mountzelizabeth123/Unphased_schematics/huxley/README.md

Board: Huxley
# Layers: 4
Board Dimensions: 4.88in x 4.88in (124mm x 124mm)
Min Size Hole: 0.01in
# Holes: 528
Assembly Both Sides: Y
Standard Chip IO: N
Blink Vias: N
Via in pads: Y
