mountzelizabeth123/Unphased_schematics/huxley/bom/huxley_v1.1.1_sierra_bom.xls

This is a sample BOM for Sierra Circuits' online BOM pricing system. Please use this preferred format for your BOM that you upload.
Note: DNI applies to whole row. If only some specific locations of a given ITEM are not to be installed, please create two rows for that item and mark one as DNI.
BOM: Huxley
Assembly Part Number/Revision: 1.1.1
Customer / Company Name: unphased CMU 18725 / Kenneth Mai
Item # | Quantity per board | Manufacturer Part # | Do Not Install | Reference designators | Vendor (optional) | Vendor Part Number (optional) | Value (optional) | Size / Footprint (optional) | Part description/ specs (optional, but recommended) | Manfacturer (optional)
1 | 12 | CBR06C329B5GACAUTO |  | C1,C2,C3,C4,C5,C6,C7,C8,C9,C10,C11,C12 | Digikey | 399-CBR06C329B5GACAUTOCT-ND | 3.19pF | C0603
2 | 14 | CC0603KRX7R7BB104 |  | C13,C16,C17,C18,C19,C22,C23,C26,C27,C34,C35,C37,C42,C43 | Digikey | 311-1088-1-ND | 0.1u | C0604
3 | 5 | GCM188R71H102KA37D | DNI | C14,C46,C49,C53,C61,C38,C44,C48,C52,C60 | Digikey | 490-4777-1-ND | 1n | C0605
4 | 10 | GCM1885C1H100JA16D | DNI | C15,C39,C45,C47,C50,C51,C54,C55,C62,C63 | Digikey | 490-4766-1-ND | 10p | C0606
5 | 6 | CL10A106MQ8NNNC |  | C20,C24,C28,C32,C36,C40 | Digikey | 1276-1119-1-ND | 10u | C0607
6 | 5 | CL10B105KP8NNNC |  | C21,C25,C29,C33,C41 | Digikey | 1276-1946-1-ND | 1u | C0608
7 | 12 |  | DNI | C64,C65,C66,C67,C68,C69,C70,C71,C72,C73,C74,C75 | Digikey |  | ~ | C0609
8 | 1 | 1N457 |  | D1 | Digikey | 1N457FS-ND | 1N457 | DO35
9 | 6 | CT3151V1-2 |  | J1,J2,J3,J24,J35,J39 | Digikey | CT3151V1-2-ND | CT3151V1-2 | Banana Plug
10 | 12 | RF2-04A-T-00-50-G |  | J4,J5,J7,J9,J11,J13,J15,J17,J18,J19,J20,J22 | Digikey | 2057-RF2-04A-T-00-50-G-ND | SMA_RF2-04A-T-00-50-G | SMA
11 | 1 | 10129382-930001BLF |  | J6 | Digikey | 10129382-930001BLF-ND | ~ | 30pin 2row 0.1" R/A
12 | 8 | 61300211121 |  | J21,J25,J26,J27,J28,J29,J30,J31 | Digikey | 732-5315-ND | 61300211121 | 0.1" 2pin header
13 | 1 | 61300311121 |  | J32 | Digikey | 732-5316-ND | 61300211121 | 0.1" 2pin header
14 | 2 | CT3151V1-0 |  | J34,J37 | Digikey | CT3151V1-0-ND | CT3151V1-0 | Banana Plug
15 | 12 | RCP0603W50R0GEB |  | R1,R2,R3,R4,R5,R6,R7,R8,R9,R10,R11,R12 | Digikey | 541-2655-1-ND | 50 | R0603
16 | 1 | RC0603FR-071K62L |  | R13 | Digikey | 311-1.62KHRCT-ND | 1.62k | R0603
17 | 1 | RC0603FR-0716K2L |  | R14 | Digikey | 311-16.2KHRCT-ND | 16.2k | R0603
18 | 1 | RT0603BRC07500RL |  | R15 | Digikey | 13-RT0603BRC07500RLCT-ND | 500 | R0603
19 | 1 | AC0603FR-0775KL |  | R16 | Digikey | YAG3629CT-ND | 75k | R0603
20 | 1 | PATT0603E8982BGT1 |  | R17 | Digikey | 764-1031-1-ND | 89.8k | R0603
21 | 1 | AC0603FR-0766K5L |  | R18 | Digikey | YAG3623CT-ND | 66.5k | R0603
22 | 1 | RMCF0603FT750K |  | R19 | Digikey | RMCF0603FT750KCT-ND | 750k | R0603
23 | 1 | RN73H1JTTD8983D50 |  | R20 | Digikey | 2019-RN73H1JTTD8983D50CT-ND | 898k | R0603
24 | 1 | RC0603FR-07665KL |  | R21 | Digikey | 311-665KHRCT-ND | 665k | R0603
25 | 1 | RMCF0603JT10K0CT-ND |  | R22 | Digikey | RMCF0603JT10K0 | 10k | R0603
26 | 1 | 225-PRS15001-12 |  | U1 | Digikey | A315-ND | ~ | PGA-ZIP pin socket
27 | 1 | LM134H |  | U2 | Digikey | 296-38977-ND | LM134H | TO-46-3
28 | 1 | MAX40201FAUA+ |  | U3 | Digikey | MAX40201FAUA+-ND | MAX40201FAUA+ | MSOP-8 (3mm)
29 | 2 | TMUX1112PWR |  | U4,U5 | Digikey | 296-TMUX1111PWRCT-ND | TMUX1112PWR | TSSOP-16 (4.4mm)
 | 1 | NVT2010PW,118 |  | U6 | Digikey | 568-5299-1-ND | NVT2010PW_118 | TSSOP-24 (4.4mm)
END OF BOM
