mountzelizabeth123/Unphased_schematics/huxley/huxley-rounded.kicad_pcb

## KiCad design huxley/huxley-rounded.kicad_pcb (2024-11-19)

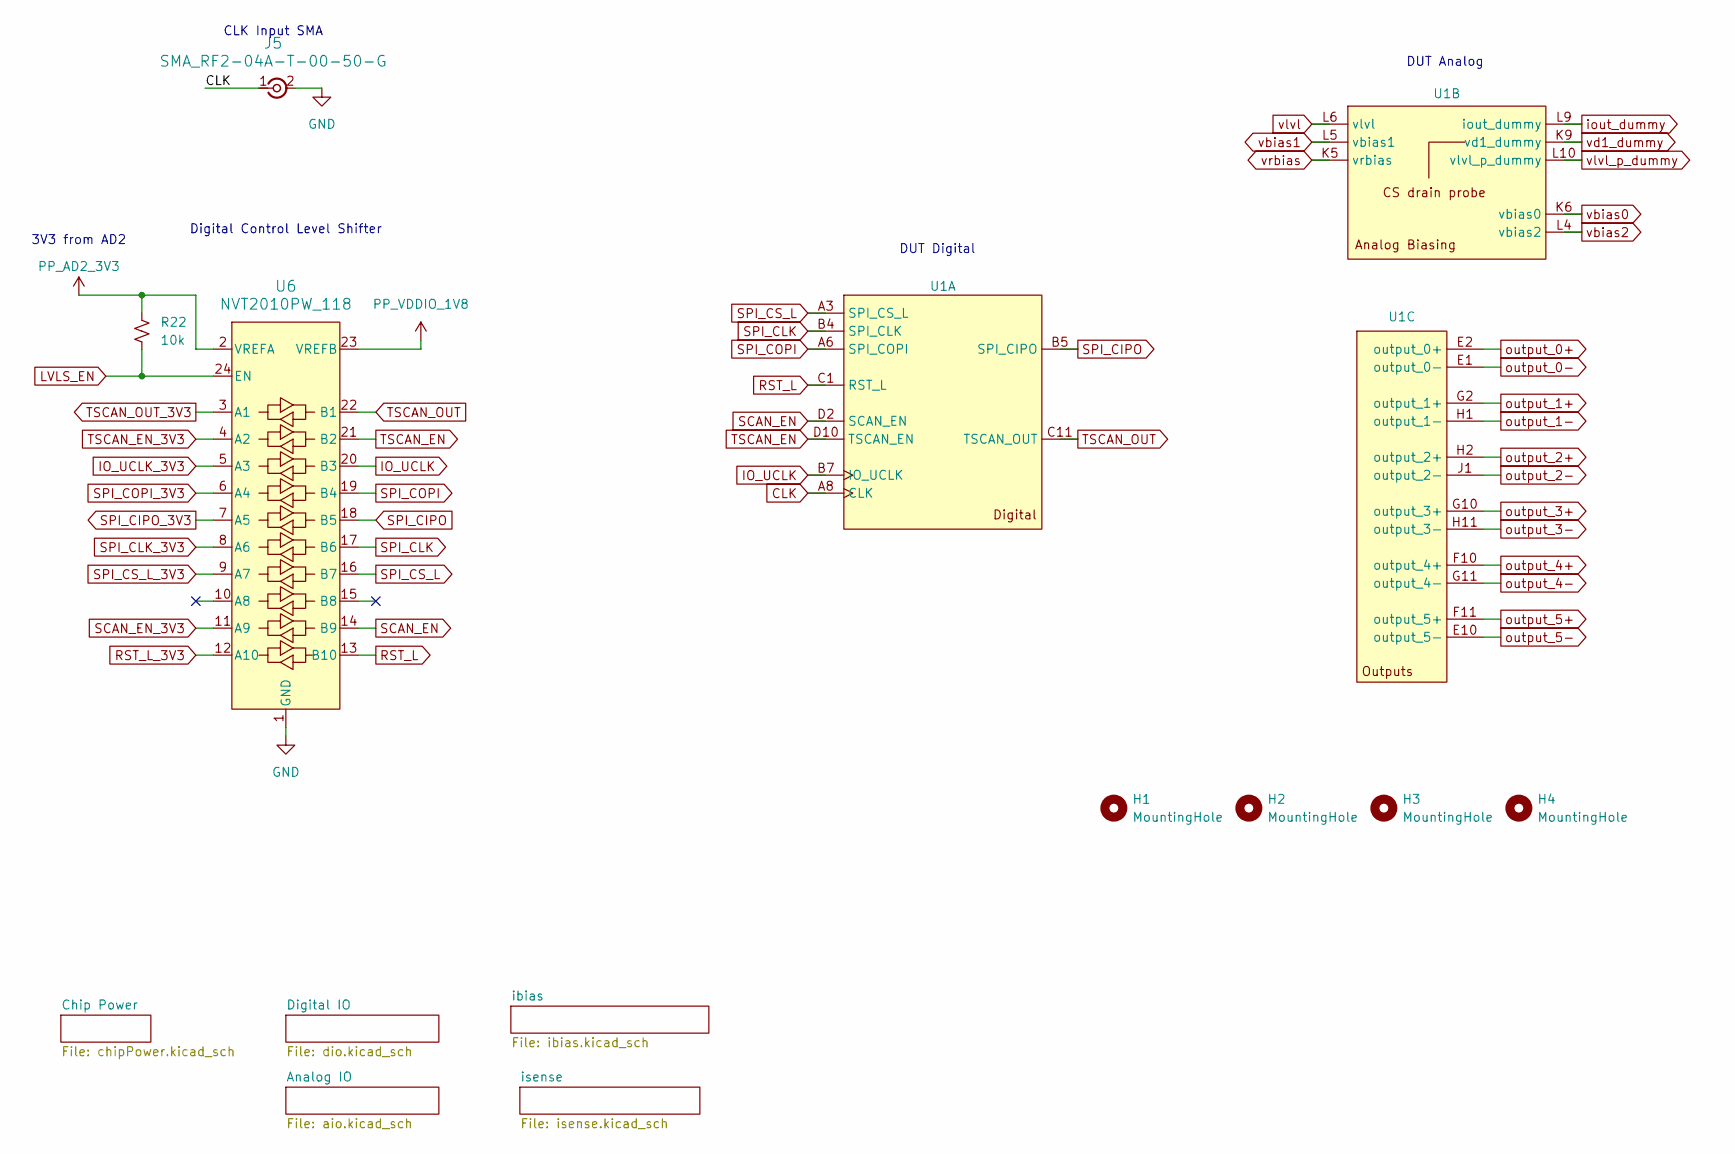
[picture p1: schematic huxley-rounded.kicad_sch]

Parts:
H1, H2, H3, H4: MountingHole; MountingHole_3.2mm_M3_DIN965_Pad_TopBottom
J5: SMA_RF2-04A-T-00-50-G; CONN_RF2-04A-T-00-50-G_ADM
R22: 10k; R_0603_1608Metric
U1: CPG08462_Full
U6: NVT2010PW_118; TSSOP24_SOT355-1_NXP

Connections:
CLK: J5.1, U1.A8 (CLK); also elsewhere on the board
GND: J5.2, J5.3 (Ext), J5.4 (Ext), J5.5 (Ext), U6.1 (GND); also elsewhere on the board
IO_UCLK: U1.B7 (IO_UCLK), U6.20 (B3)
IO_UCLK_3V3: U6.5 (A3); also elsewhere on the board
LVLS_EN: R22.2, U6.24 (EN); also elsewhere on the board
PP_AD2_3V3: R22.1, U6.2 (VREFA); also elsewhere on the board
PP_VDDIO_1V8: U6.23 (VREFB); also elsewhere on the board
RST_L: U1.C1 (RST_L), U6.13 (B10)
RST_L_3V3: U6.12 (A10); also elsewhere on the board
SCAN_EN: U1.D2 (SCAN_EN), U6.14 (B9)
SCAN_EN_3V3: U6.11 (A9); also elsewhere on the board
SPI_CIPO: U1.B5 (SPI_CIPO), U6.18 (B5)
SPI_CIPO_3V3: U6.7 (A5); also elsewhere on the board
SPI_CLK: U1.B4 (SPI_CLK), U6.17 (B6)
SPI_CLK_3V3: U6.8 (A6); also elsewhere on the board
SPI_COPI: U1.A6 (SPI_COPI), U6.19 (B4)
SPI_COPI_3V3: U6.6 (A4); also elsewhere on the board
SPI_CS_L: U1.A3 (SPI_CS_L), U6.16 (B7)
SPI_CS_L_3V3: U6.9 (A7); also elsewhere on the board
TSCAN_EN: U1.D10 (TSCAN_EN), U6.21 (B2)
TSCAN_EN_3V3: U6.4 (A2); also elsewhere on the board
TSCAN_OUT: U1.C11 (TSCAN_OUT), U6.22 (B1)
TSCAN_OUT_3V3: U6.3 (A1); also elsewhere on the board
iout_dummy: U1.L9 (iout_dummy); also elsewhere on the board
output_0+: U1.E2 (output_0+); also elsewhere on the board
output_0-: U1.E1 (output_0-); also elsewhere on the board
output_1+: U1.G2 (output_1+); also elsewhere on the board
output_1-: U1.H1 (output_1-); also elsewhere on the board
output_2+: U1.H2 (output_2+); also elsewhere on the board
output_2-: U1.J1 (output_2-); also elsewhere on the board
output_3+: U1.G10 (output_3+); also elsewhere on the board
output_3-: U1.H11 (output_3-); also elsewhere on the board
output_4+: U1.F10 (output_4+); also elsewhere on the board
output_4-: U1.G11 (output_4-); also elsewhere on the board
output_5+: U1.F11 (output_5+); also elsewhere on the board
output_5-: U1.E10 (output_5-); also elsewhere on the board
vbias0: U1.K6 (vbias0); also elsewhere on the board
vbias1: U1.L5 (vbias1); also elsewhere on the board
vbias2: U1.L4 (vbias2); also elsewhere on the board
vd1_dummy: U1.K9 (vd1_dummy); also elsewhere on the board
vlvl: U1.L6 (vlvl); also elsewhere on the board
vlvl_p_dummy: U1.L10 (vlvl_p_dummy); also elsewhere on the board
vrbias: U1.K5 (vrbias); also elsewhere on the board

Notes on the sheet:
DUT Digital
DUT Analog
CLK Input SMA
3V3 from AD2
Digital Control Level Shifter

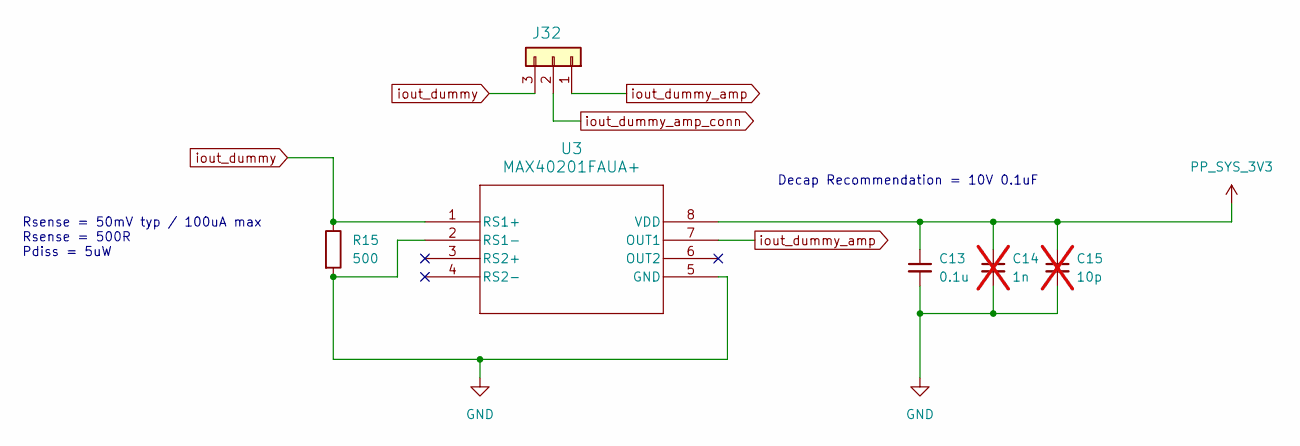
[picture p2: schematic isense.kicad_sch]

Parts:
C13: 0.1u; C_0603_1608Metric
C14: 1n; C_0603_1608Metric; not fitted
C15: 10p; C_0603_1608Metric; not fitted
J32: 61300211121; PinHeader_1x03_P2.54mm_Vertical
R15: 500; R_0603_1608Metric
U3: MAX40201FAUA+

Connections:
GND: C13.2, C14.2, C15.2, R15.2, U3.2 (RS1-), U3.5 (GND); also elsewhere on the board
PP_SYS_3V3: C13.1, C14.1, C15.1, U3.8 (VDD); also elsewhere on the board
iout_dummy: J32.3, R15.1, U3.1 (RS1+); also elsewhere on the board
iout_dummy_amp: J32.1, U3.7 (OUT1)
iout_dummy_amp_conn: J32.2; also elsewhere on the board

Notes on the sheet:
Decap Recommendation = 10V 0.1uF
Rsense = 50mV typ / 100uA max Rsense = 500R Pdiss = 5uW

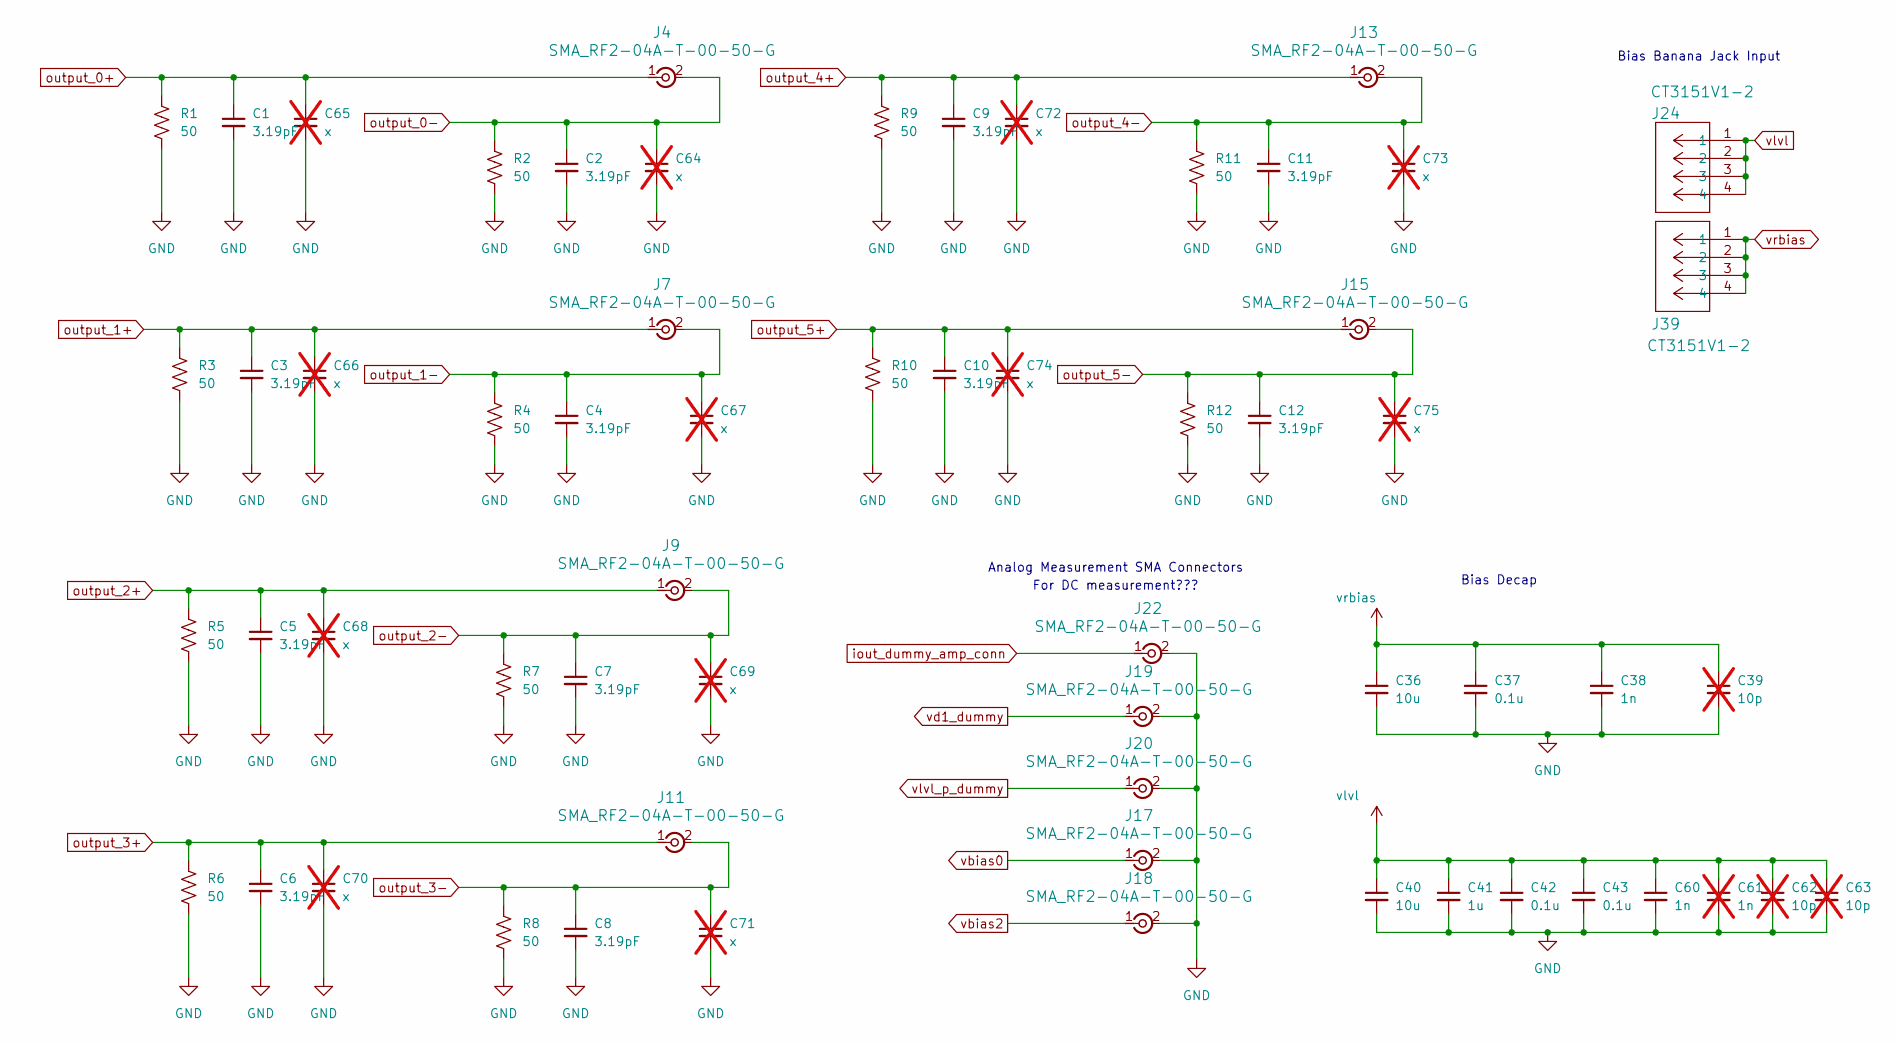
[picture p3: schematic aio.kicad_sch]

Parts:
C1, C2, C3, C4, C5, C6, C7, C8, C9, C10, C11, C12: 3.19pF; C_0603_1608Metric
C36, C40: 10u; C_0603_1608Metric
C37, C42, C43: 0.1u; C_0603_1608Metric
C38, C60: 1n; C_0603_1608Metric
C39, C62, C63: 10p; C_0603_1608Metric; not fitted
C41: 1u; C_0603_1608Metric
C61: 1n; C_0603_1608Metric; not fitted
C64, C65, C66, C67, C68, C69, C70, C71, C72, C73, C74, C75: x; C_0603_1608Metric; not fitted
J4, J7, J9, J11, J13, J15, J17, J18, J19, J20, J22: SMA_RF2-04A-T-00-50-G; CONN_RF2-04A-T-00-50-G_ADM
J24, J39: CT3151V1-2; banana_plug_CT3151V1-0
R1, R2, R3, R4, R5, R6, R7, R8, R9, R10, R11, R12: 50; R_0603_1608Metric_Vishay_WBT

Connections:
GND: C1.2, C2.2, C3.2, C4.2, C5.2, C6.2, C7.2, C8.2, C9.2, C10.2, C11.2, C12.2, C36.2, C37.2, C38.2, C39.2, C40.2, C41.2, C42.2, C43.2, C60.2, C61.2, C62.2, C63.2, C64.2, C65.2, C66.2, C67.2, C68.2, C69.2, C70.2, C71.2, C72.2, C73.2, C74.2, C75.2, J17.2, J17.3 (Ext), J17.4 (Ext), J17.5 (Ext), J18.2, J18.3 (Ext), J18.4 (Ext), J18.5 (Ext), J19.2, J19.3 (Ext), J19.4 (Ext), J19.5 (Ext), J20.2, J20.3 (Ext), J20.4 (Ext), J20.5 (Ext), J22.2, J22.3 (Ext), J22.4 (Ext), J22.5 (Ext), R1.2, R2.2, R3.2, R4.2, R5.2, R6.2, R7.2, R8.2, R9.2, R10.2, R11.2, R12.2; also elsewhere on the board
iout_dummy_amp_conn: J22.1; also elsewhere on the board
output_0+: C1.1, C65.1, J4.1, R1.1; also elsewhere on the board
output_0-: C2.1, C64.1, J4.2, J4.3 (Ext), J4.4 (Ext), J4.5 (Ext), R2.1; also elsewhere on the board
output_1+: C3.1, C66.1, J7.1, R3.1; also elsewhere on the board
output_1-: C4.1, C67.1, J7.2, J7.3 (Ext), J7.4 (Ext), J7.5 (Ext), R4.1; also elsewhere on the board
output_2+: C5.1, C68.1, J9.1, R5.1; also elsewhere on the board
output_2-: C7.1, C69.1, J9.2, J9.3 (Ext), J9.4 (Ext), J9.5 (Ext), R7.1; also elsewhere on the board
output_3+: C6.1, C70.1, J11.1, R6.1; also elsewhere on the board
output_3-: C8.1, C71.1, J11.2, J11.3 (Ext), J11.4 (Ext), J11.5 (Ext), R8.1; also elsewhere on the board
output_4+: C9.1, C72.1, J13.1, R9.1; also elsewhere on the board
output_4-: C11.1, C73.1, J13.2, J13.3 (Ext), J13.4 (Ext), J13.5 (Ext), R11.1; also elsewhere on the board
output_5+: C10.1, C74.1, J15.1, R10.1; also elsewhere on the board
output_5-: C12.1, C75.1, J15.2, J15.3 (Ext), J15.4 (Ext), J15.5 (Ext), R12.1; also elsewhere on the board
vbias0: J17.1; also elsewhere on the board
vbias2: J18.1; also elsewhere on the board
vd1_dummy: J19.1; also elsewhere on the board
vlvl: C40.1, C41.1, C42.1, C43.1, C60.1, C61.1, C62.1, C63.1, J24.1, J24.2, J24.3, J24.4; also elsewhere on the board
vlvl_p_dummy: J20.1; also elsewhere on the board
vrbias: C36.1, C37.1, C38.1, C39.1, J39.1, J39.2, J39.3, J39.4; also elsewhere on the board

Notes on the sheet:
Analog Measurement SMA Connectors
Bias Decap
Bias Banana Jack Input
For DC measurement???

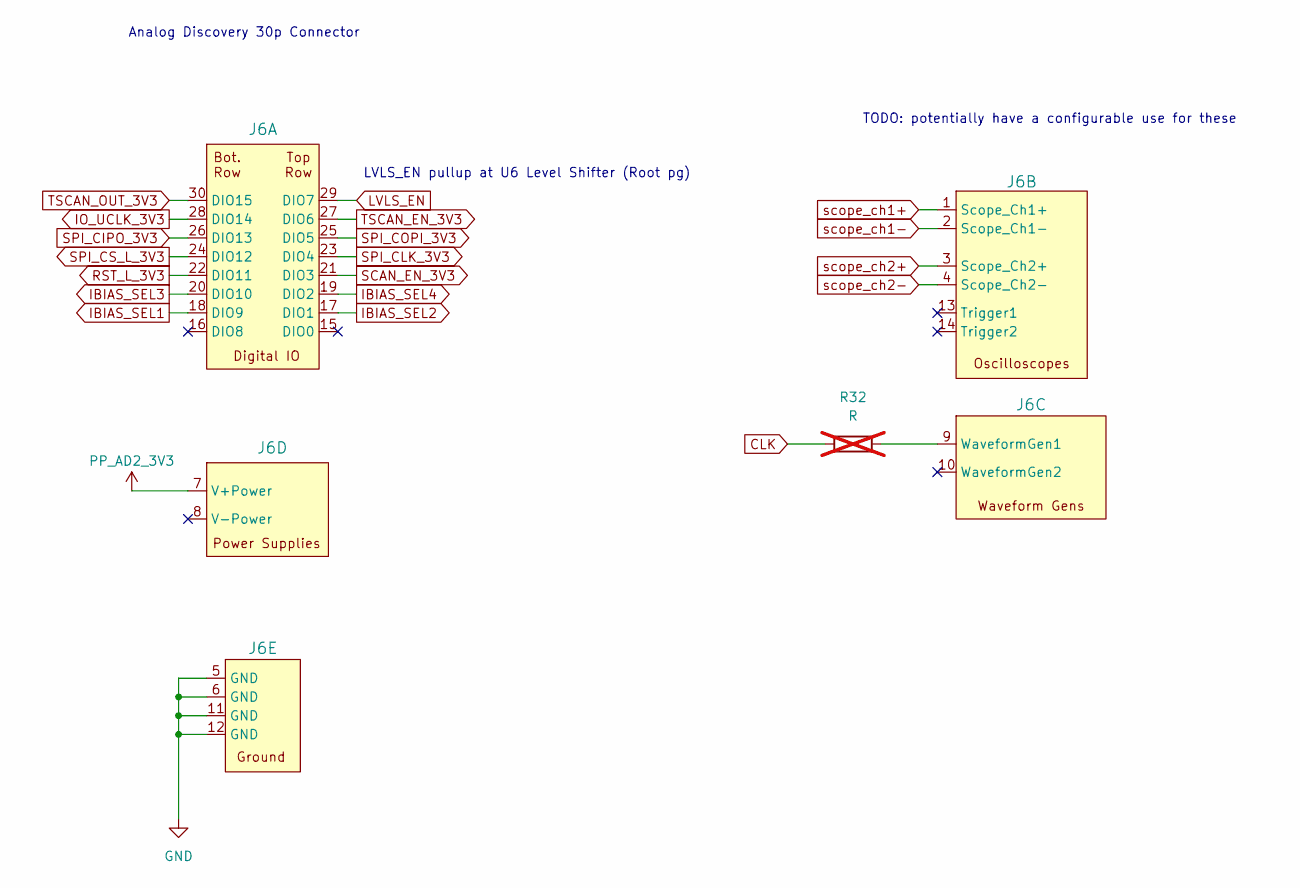
[picture p4: schematic dio.kicad_sch]

Parts:
J6: PinHeader_2x15_P2.54mm_Horizontal
R32: R; R_0603_1608Metric; not fitted

Connections:
CLK: R32.1; also elsewhere on the board
GND: J6.5 (GND), J6.6 (GND), J6.11 (GND), J6.12 (GND); also elsewhere on the board
IBIAS_SEL1: J6.18 (DIO9); also elsewhere on the board
IBIAS_SEL2: J6.17 (DIO1); also elsewhere on the board
IBIAS_SEL3: J6.20 (DIO10); also elsewhere on the board
IBIAS_SEL4: J6.19 (DIO2); also elsewhere on the board
IO_UCLK_3V3: J6.28 (DIO14); also elsewhere on the board
LVLS_EN: J6.29 (DIO7); also elsewhere on the board
unnamed: J6.9 (WaveformGen1), R32.2
PP_AD2_3V3: J6.7 (V+Power); also elsewhere on the board
RST_L_3V3: J6.22 (DIO11); also elsewhere on the board
SCAN_EN_3V3: J6.21 (DIO3); also elsewhere on the board
SPI_CIPO_3V3: J6.26 (DIO13); also elsewhere on the board
SPI_CLK_3V3: J6.23 (DIO4); also elsewhere on the board
SPI_COPI_3V3: J6.25 (DIO5); also elsewhere on the board
SPI_CS_L_3V3: J6.24 (DIO12); also elsewhere on the board
TSCAN_EN_3V3: J6.27 (DIO6); also elsewhere on the board
TSCAN_OUT_3V3: J6.30 (DIO15); also elsewhere on the board
scope_ch1+: J6.1 (Scope_Ch1+)
scope_ch1-: J6.2 (Scope_Ch1-)
scope_ch2+: J6.3 (Scope_Ch2+)
scope_ch2-: J6.4 (Scope_Ch2-)

Notes on the sheet:
Analog Discovery 30p Connector
LVLS_EN pullup at U6 Level Shifter (Root pg)
TODO: potentially have a configurable use for these

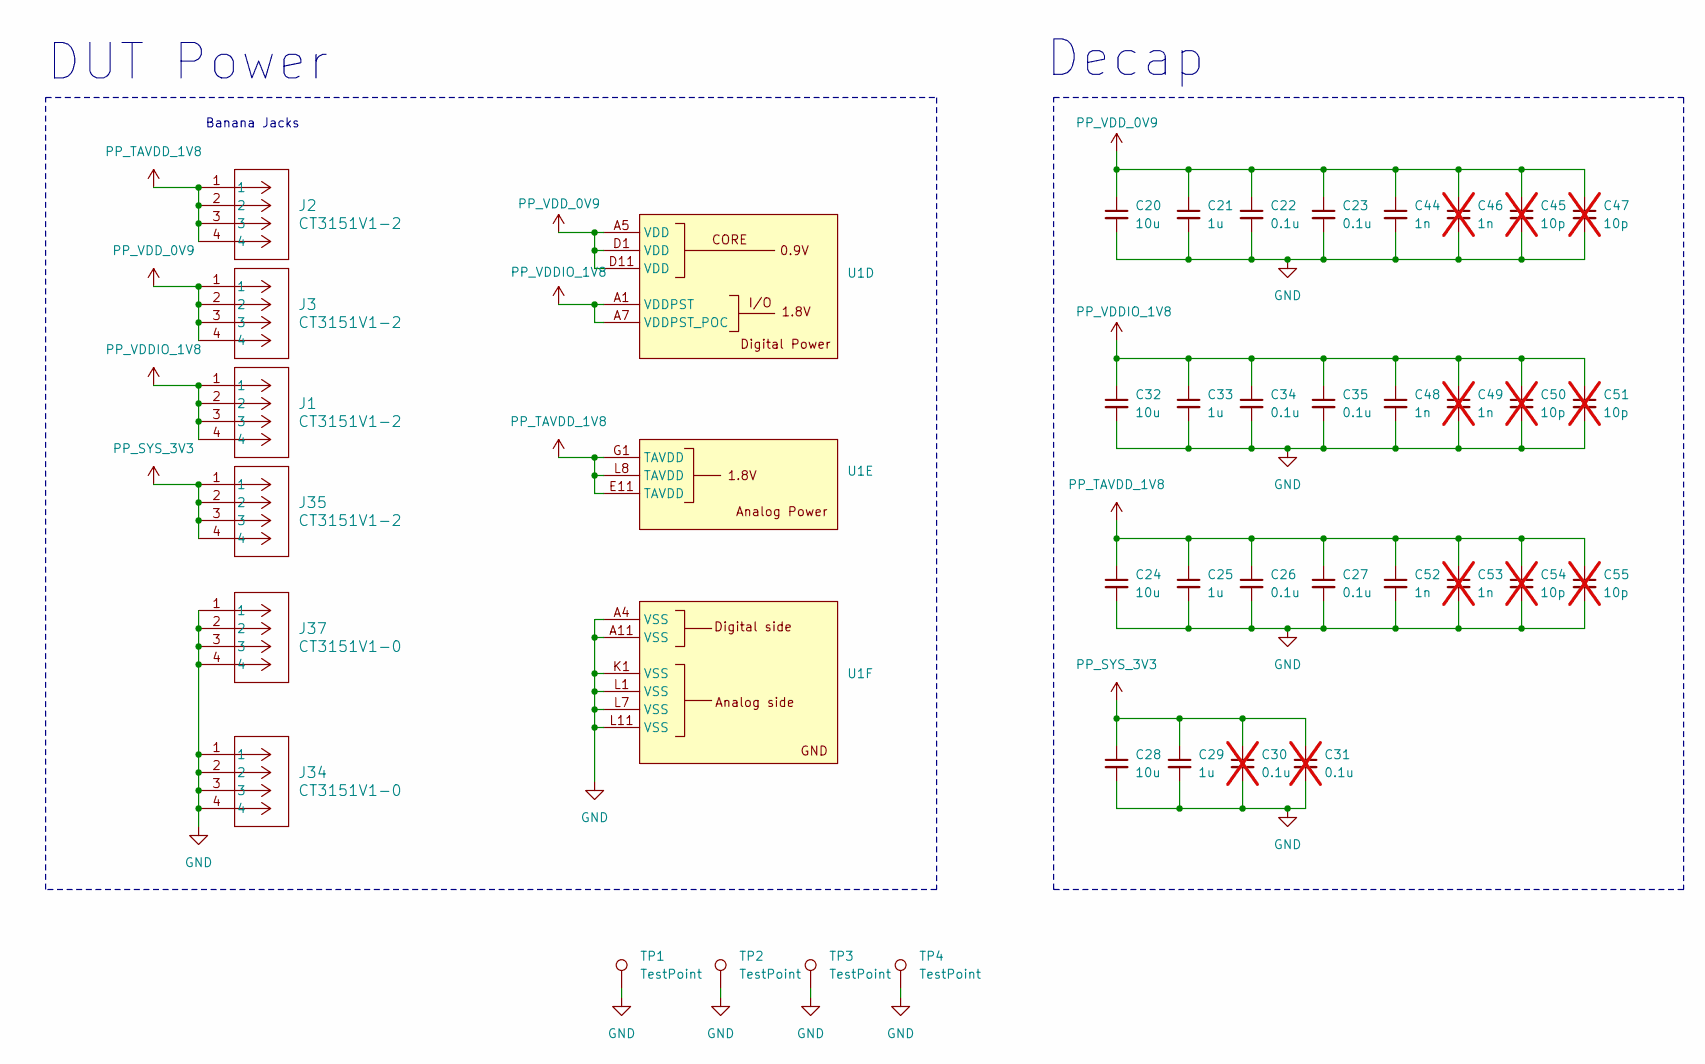
[picture p5: schematic chipPower.kicad_sch]

Parts:
C20, C24, C28, C32: 10u; C_0603_1608Metric
C21, C25, C29, C33: 1u; C_0603_1608Metric
C22, C23, C26, C27, C34, C35: 0.1u; C_0603_1608Metric
C30, C31: 0.1u; C_0603_1608Metric; not fitted
C44, C48, C52: 1n; C_0603_1608Metric
C45, C47, C50, C51, C54, C55: 10p; C_0603_1608Metric; not fitted
C46, C49, C53: 1n; C_0603_1608Metric; not fitted
J1, J2, J3, J35: CT3151V1-2; banana_plug_CT3151V1-0
J34, J37: CT3151V1-0; banana_plug_CT3151V1-0
TP1, TP2, TP3, TP4: TestPoint; TestPoint_Pad_D3.0mm
U1: CPG08462_Full

Connections:
GND: C20.2, C21.2, C22.2, C23.2, C24.2, C25.2, C26.2, C27.2, C28.2, C29.2, C30.2, C31.2, C32.2, C33.2, C34.2, C35.2, C44.2, C45.2, C46.2, C47.2, C48.2, C49.2, C50.2, C51.2, C52.2, C53.2, C54.2, C55.2, J34.1, J34.2, J34.3, J34.4, J37.1, J37.2, J37.3, J37.4, TP1.1, TP2.1, TP3.1, TP4.1, U1.A4 (VSS), U1.A11 (VSS), U1.K1 (VSS), U1.L1 (VSS), U1.L7 (VSS), U1.L11 (VSS); also elsewhere on the board
PP_SYS_3V3: C28.1, C29.1, C30.1, C31.1, J35.1, J35.2, J35.3, J35.4; also elsewhere on the board
PP_TAVDD_1V8: C24.1, C25.1, C26.1, C27.1, C52.1, C53.1, C54.1, C55.1, J2.1, J2.2, J2.3, J2.4, U1.E11 (TAVDD), U1.G1 (TAVDD), U1.L8 (TAVDD)
PP_VDDIO_1V8: C32.1, C33.1, C34.1, C35.1, C48.1, C49.1, C50.1, C51.1, J1.1, J1.2, J1.3, J1.4, U1.A1 (VDDPST), U1.A7 (VDDPST_POC); also elsewhere on the board
PP_VDD_0V9: C20.1, C21.1, C22.1, C23.1, C44.1, C45.1, C46.1, C47.1, J3.1, J3.2, J3.3, J3.4, U1.A5 (VDD), U1.D1 (VDD), U1.D11 (VDD)

Notes on the sheet:
Decap
DUT Power
Banana Jacks

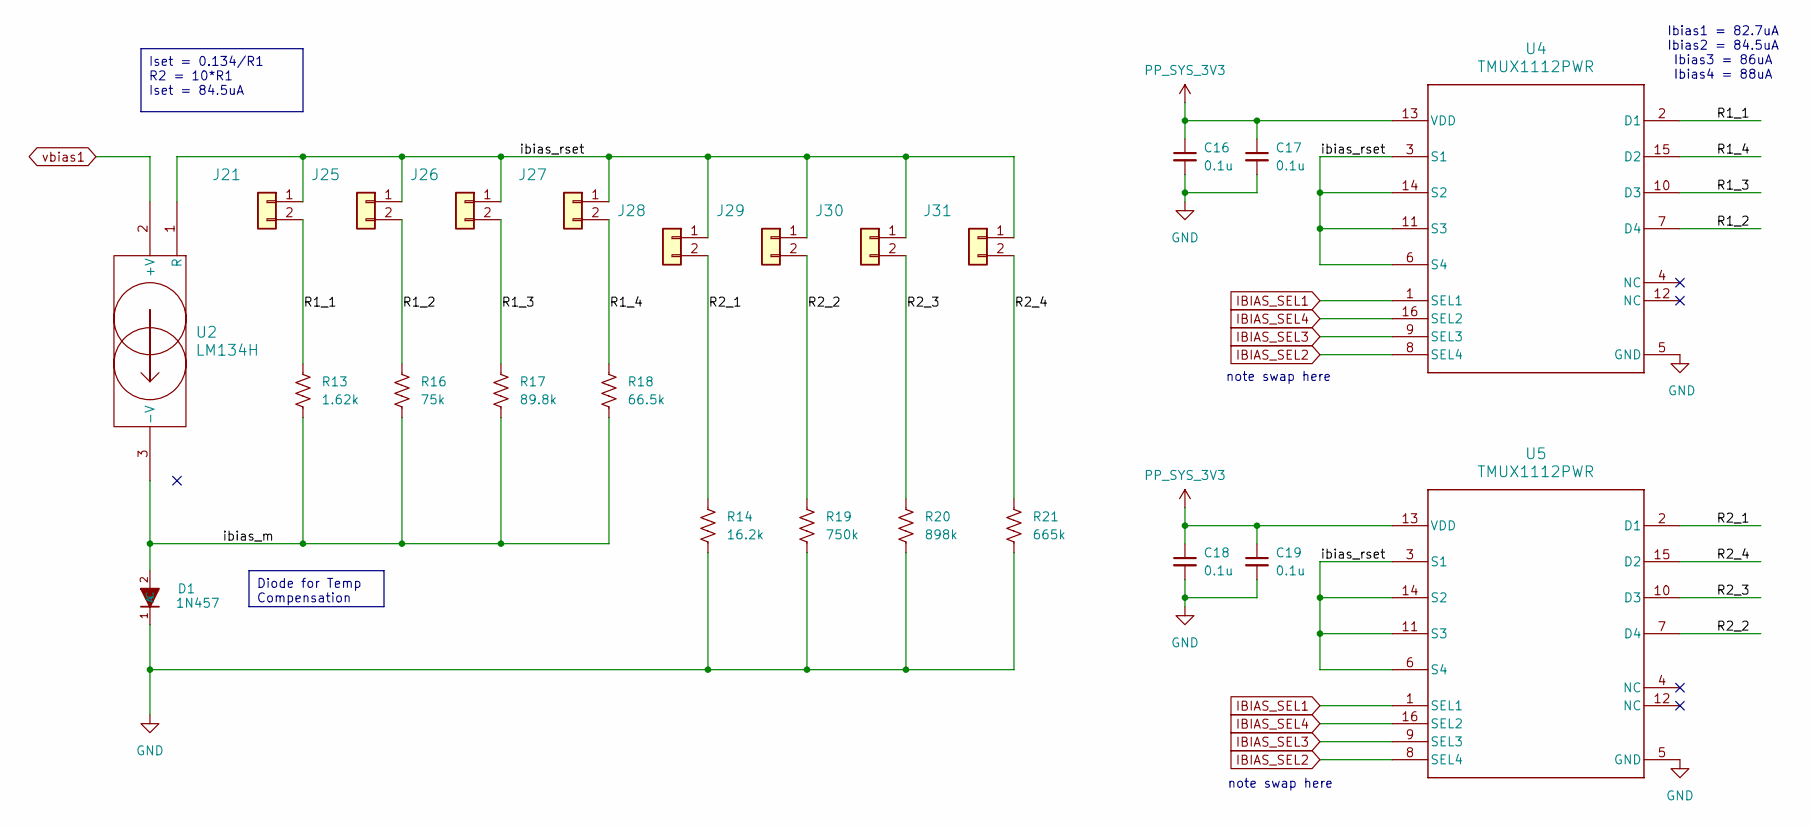
[picture p6: schematic ibias.kicad_sch]

Parts:
C16, C17, C18, C19: 0.1u; C_0603_1608Metric
D1: 1N457; DIO_1N457; MPN 1N457
J21, J25, J26, J27, J28, J29, J30, J31: 61300211121; PinHeader_1x02_P2.54mm_Vertical
R13: 1.62k; R_0603_1608Metric
R14: 16.2k; R_0603_1608Metric
R16: 75k; R_0603_1608Metric
R17: 89.8k; R_0603_1608Metric
R18: 66.5k; R_0603_1608Metric
R19: 750k; R_0603_1608Metric
R20: 898k; R_0603_1608Metric
R21: 665k; R_0603_1608Metric
U2: LM134H; TO-46-3
U4, U5: TMUX1112PWR; TSSOP-16_4.4x5mm_P0.65mm

Connections:
/ibias/R1_1: J21.2, R13.1, U4.2 (D1)
/ibias/R1_2: J25.2, R16.1, U4.7 (D4)
/ibias/R1_3: J26.2, R17.1, U4.10 (D3)
/ibias/R1_4: J27.2, R18.1, U4.15 (D2)
/ibias/R2_1: J28.2, R14.1, U5.2 (D1)
/ibias/R2_2: J29.2, R19.1, U5.7 (D4)
/ibias/R2_3: J30.2, R20.1, U5.10 (D3)
/ibias/R2_4: J31.2, R21.1, U5.15 (D2)
/ibias/ibias_m: D1.2 (A), R13.2, R16.2, R17.2, R18.2, U2.3 (-V)
/ibias/ibias_rset: J21.1, J25.1, J26.1, J27.1, J28.1, J29.1, J30.1, J31.1, U2.1 (R), U4.3 (S1), U4.6 (S4), U4.11 (S3), U4.14 (S2), U5.3 (S1), U5.6 (S4), U5.11 (S3), U5.14 (S2)
GND: C16.2, C17.2, C18.2, C19.2, D1.1 (C), R14.2, R19.2, R20.2, R21.2, U4.5 (GND), U5.5 (GND); also elsewhere on the board
IBIAS_SEL1: U4.1 (SEL1), U5.1 (SEL1); also elsewhere on the board
IBIAS_SEL2: U4.8 (SEL4), U5.8 (SEL4); also elsewhere on the board
IBIAS_SEL3: U4.9 (SEL3), U5.9 (SEL3); also elsewhere on the board
IBIAS_SEL4: U4.16 (SEL2), U5.16 (SEL2); also elsewhere on the board
PP_SYS_3V3: C16.1, C17.1, C18.1, C19.1, U4.13 (VDD), U5.13 (VDD); also elsewhere on the board
vbias1: U2.2 (+V); also elsewhere on the board

Notes on the sheet:
Iset = 0.134/R1 R2 = 10*R1 Iset = 84.5uA
Diode for Temp Compensation
Ibias1 = 82.7uA Ibias2 = 84.5uA Ibias3 = 86uA Ibias4 = 88uA
note swap here

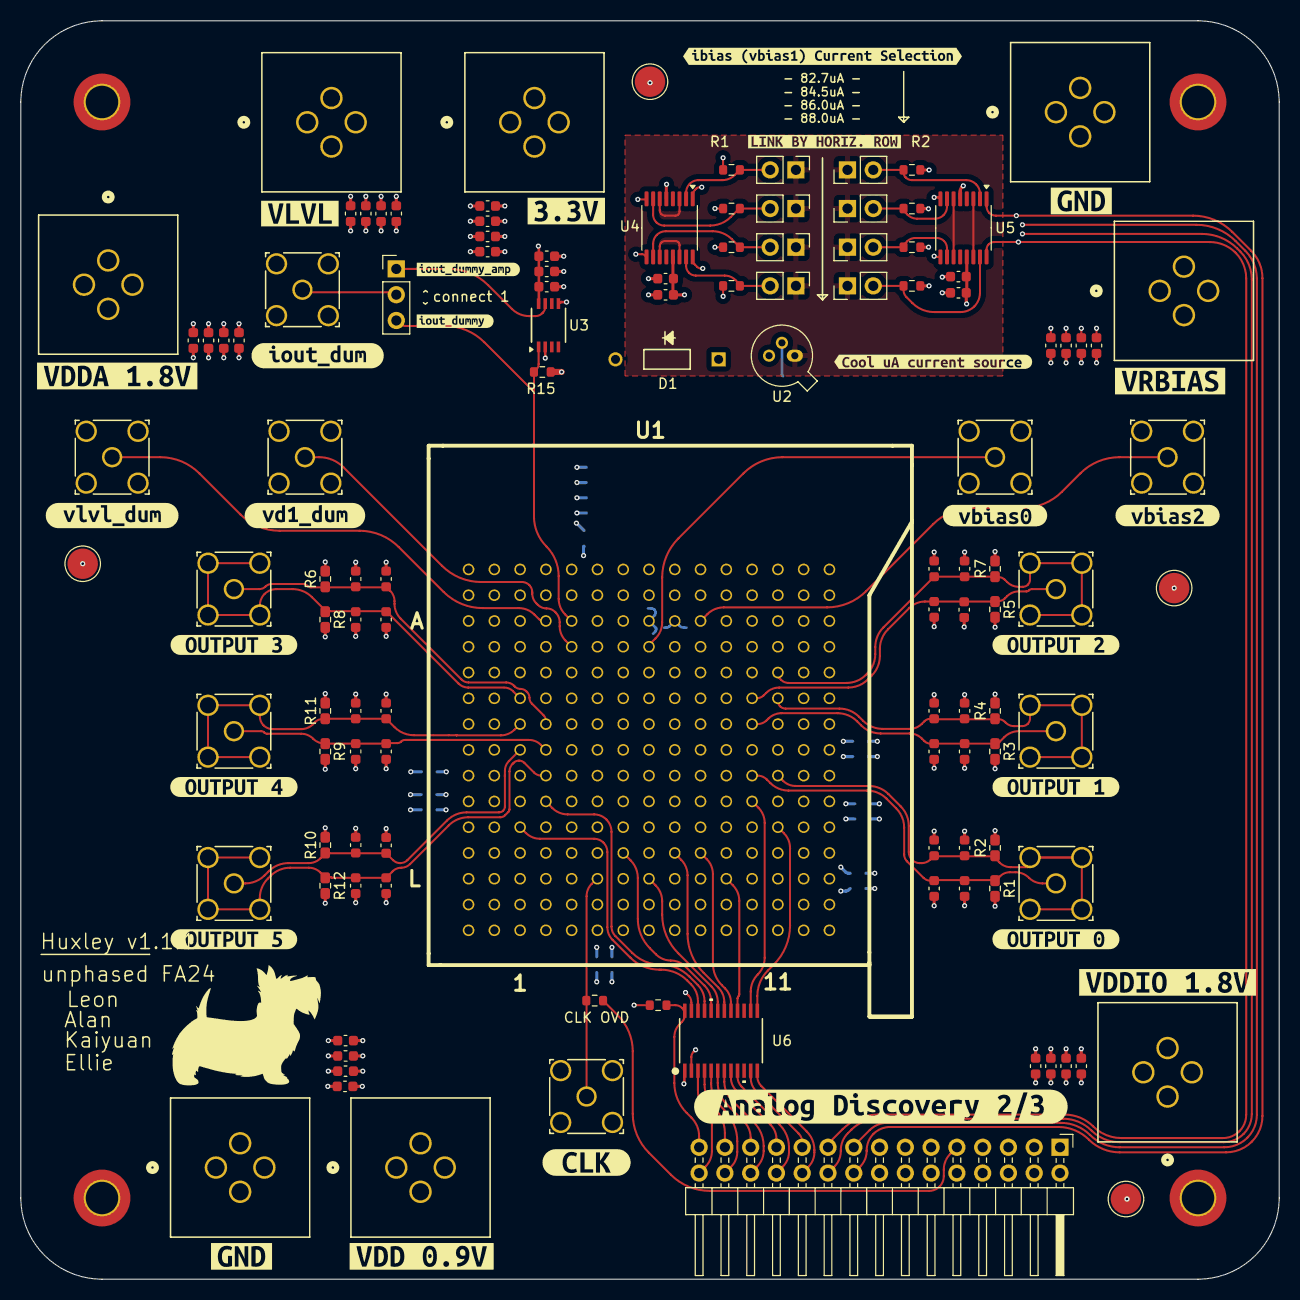
[picture p7: board huxley-rounded.kicad_pcb from above]

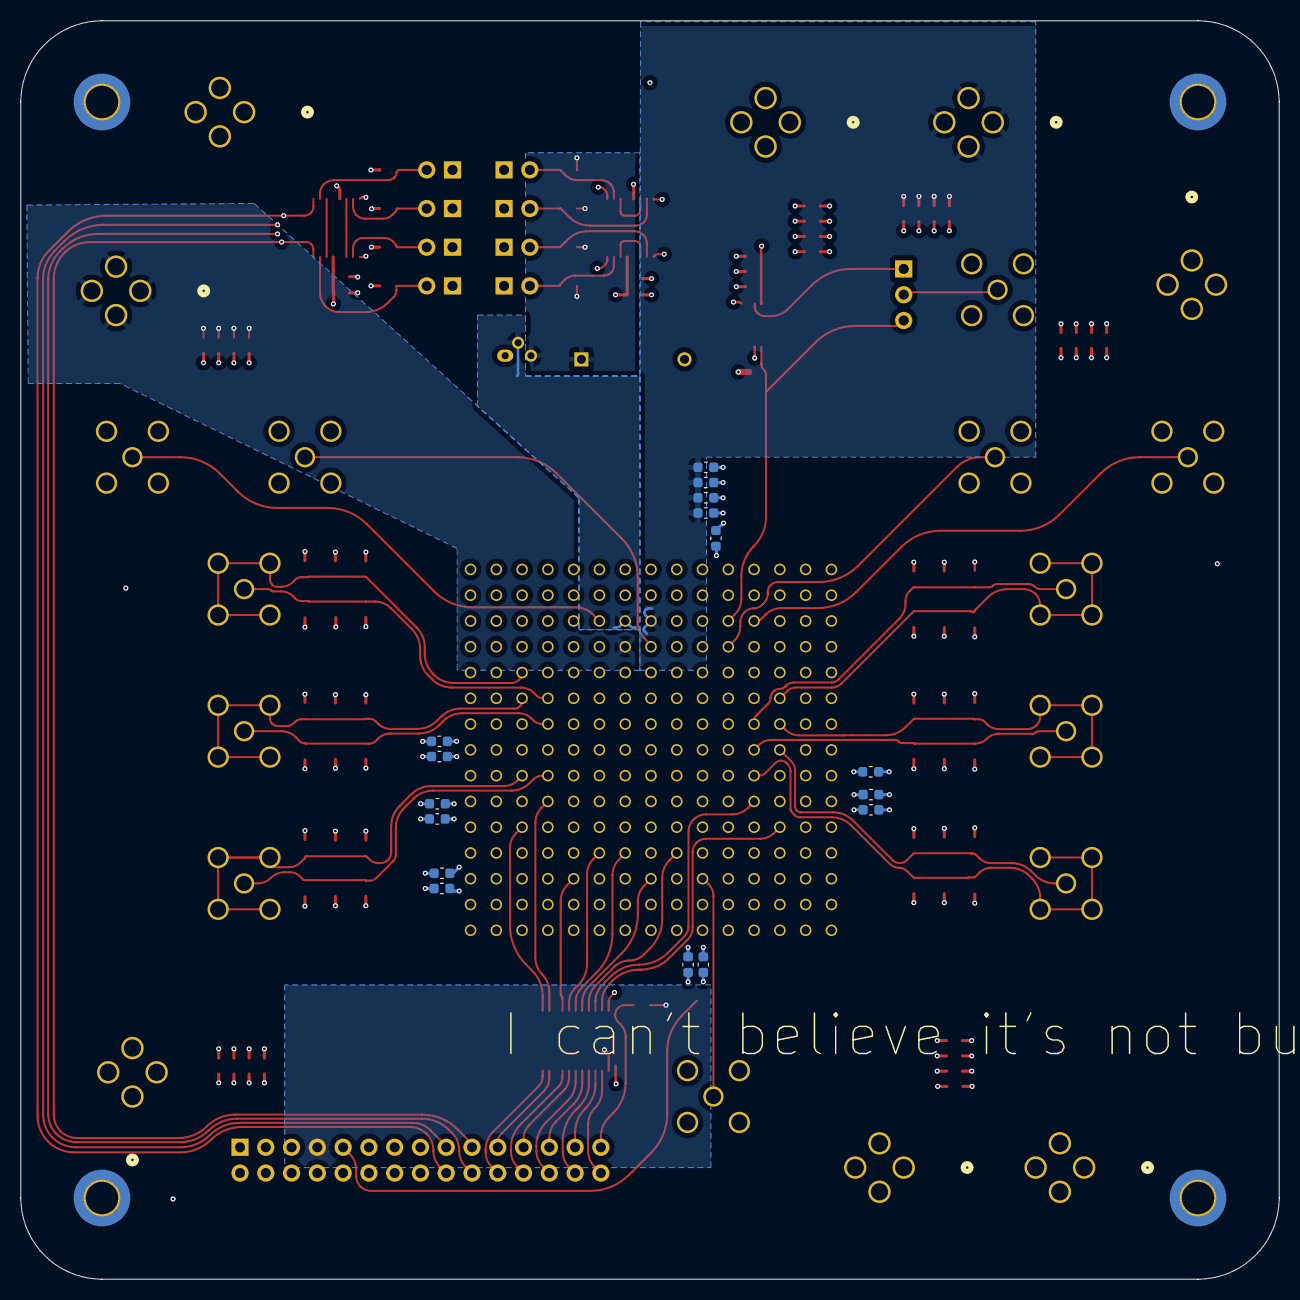
[picture p8: board huxley-rounded.kicad_pcb from below]

Board: 4 copper layers, 124.0 x 124.0 mm, 165 parts (16 on the bottom side), 63 nets.

Other parts of the board:
kibuzzard-6717DA4B: G***; kibuzzard-6717DA4B
kibuzzard-6717DA65: G***; kibuzzard-6717DA65
kibuzzard-6717E4EA: G***; kibuzzard-6717E4EA
kibuzzard-6717E6BD: G***; kibuzzard-6717E6BD
kibuzzard-6717E6C2: G***; kibuzzard-6717E6C2
kibuzzard-6717E6C7: G***; kibuzzard-6717E6C7
kibuzzard-6717E514: G***; kibuzzard-6717E514
kibuzzard-6717E567: G***; kibuzzard-6717E567
kibuzzard-6717E572: G***; kibuzzard-6717E572
kibuzzard-6717E585: G***; kibuzzard-6717E585
kibuzzard-6717ED1A, kibuzzard-6717ED1A#2: G***; kibuzzard-6717ED1A
kibuzzard-6717ED7A: G***; kibuzzard-6717ED7A
kibuzzard-6717ED42: G***; kibuzzard-6717ED42
kibuzzard-6717ED63: G***; kibuzzard-6717ED63
kibuzzard-6717ED92: G***; kibuzzard-6717ED92
kibuzzard-6717EDA4: G***; kibuzzard-6717EDA4
kibuzzard-6717EDC6: G***; kibuzzard-6717EDC6
kibuzzard-6717EEBB: G***; kibuzzard-6717EEBB
kibuzzard-6717EECA: G***; kibuzzard-6717EECA
kibuzzard-6717EEDA: G***; kibuzzard-6717EEDA
kibuzzard-6717EF01: G***; kibuzzard-6717EF01
kibuzzard-6717EF05: G***; kibuzzard-6717EF05
kibuzzard-6717EF67: G***; kibuzzard-6717EF67
kibuzzard-6717F3BE: G***; kibuzzard-6717F3BE
kibuzzard-6717F38C: G***; kibuzzard-6717F38C
