mountzelizabeth123/Unphased_schematics/amp_board/amp_board.kicad_pcb

## KiCad design amp_board/amp_board.kicad_pcb (2024-10-23)

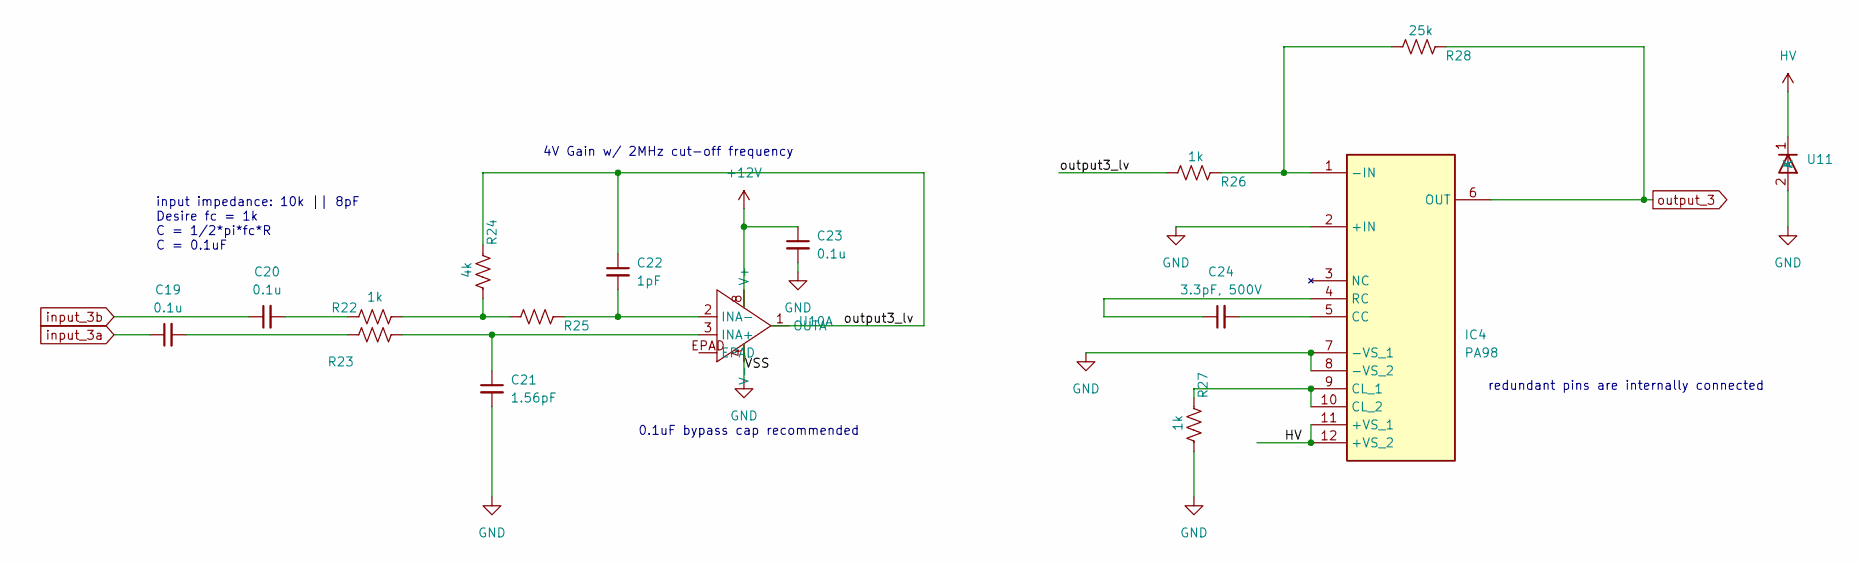
[picture p9: schematic amp_3.kicad_sch]

Parts:
C19, C20, C23: 0.1u; C_0603_1608Metric
C21: 1.56pF; C_0603_1608Metric
C22: 1pF; C_0603_1608Metric
C24: 3.3pF, 500V; C_0805_2012Metric
IC4: PA98; Mouser Part Number 137-PA98
R22, R26, R27: 1k; R_0603_1608Metric
R23, R25: R_US; R_0603_1608Metric
R24: 4k; R_0603_1608Metric
R28: 25k; R_0603_1608Metric
U10: OPA2211AIDDAR_L
U11: SMCJ150A-13-F

Connections:
+12V: C23.1, U10.8 (V+); also elsewhere on the board
/amp_3/output3_lv: C22.1, R24.1, R26.2, U10.1 (OUTA)
GND: C21.2, C23.2, IC4.2 (+IN), IC4.7 (-VS_1), IC4.8 (-VS_2), R27.2, U10.4 (V-), U11.2 (A); also elsewhere on the board
HV: IC4.11 (+VS_1), IC4.12 (+VS_2), U11.1 (K); also elsewhere on the board
unnamed: C19.2, R23.2
unnamed: C20.2, R22.2
unnamed: IC4.1 (-IN), R26.1, R28.2
unnamed: C24.2, IC4.5 (CC)
unnamed: IC4.9 (CL_1), IC4.10 (CL_2), R27.1
unnamed: C24.1, IC4.4 (RC)
unnamed: R22.1, R24.2, R25.2
unnamed: C21.1, R23.1, U10.3 (INA+)
unnamed: C22.2, R25.1, U10.2 (INA-)
input_3a: C19.1; also elsewhere on the board
input_3b: C20.1; also elsewhere on the board
output_3: IC4.6 (OUT), R28.1; also elsewhere on the board

Notes on the sheet:
input impedance: 10k || 8pF Desire fc = 1k C = 1/2*pi*fc*R C = 0.1uF
0.1uF bypass cap recommended
4V Gain w/ 2MHz cut-off frequency
redundant pins are internally connected
