mountzelizabeth123/Unphased_schematics/amp_board/amp_board.kicad_pcb

## KiCad design amp_board/amp_board.kicad_pcb (continued)

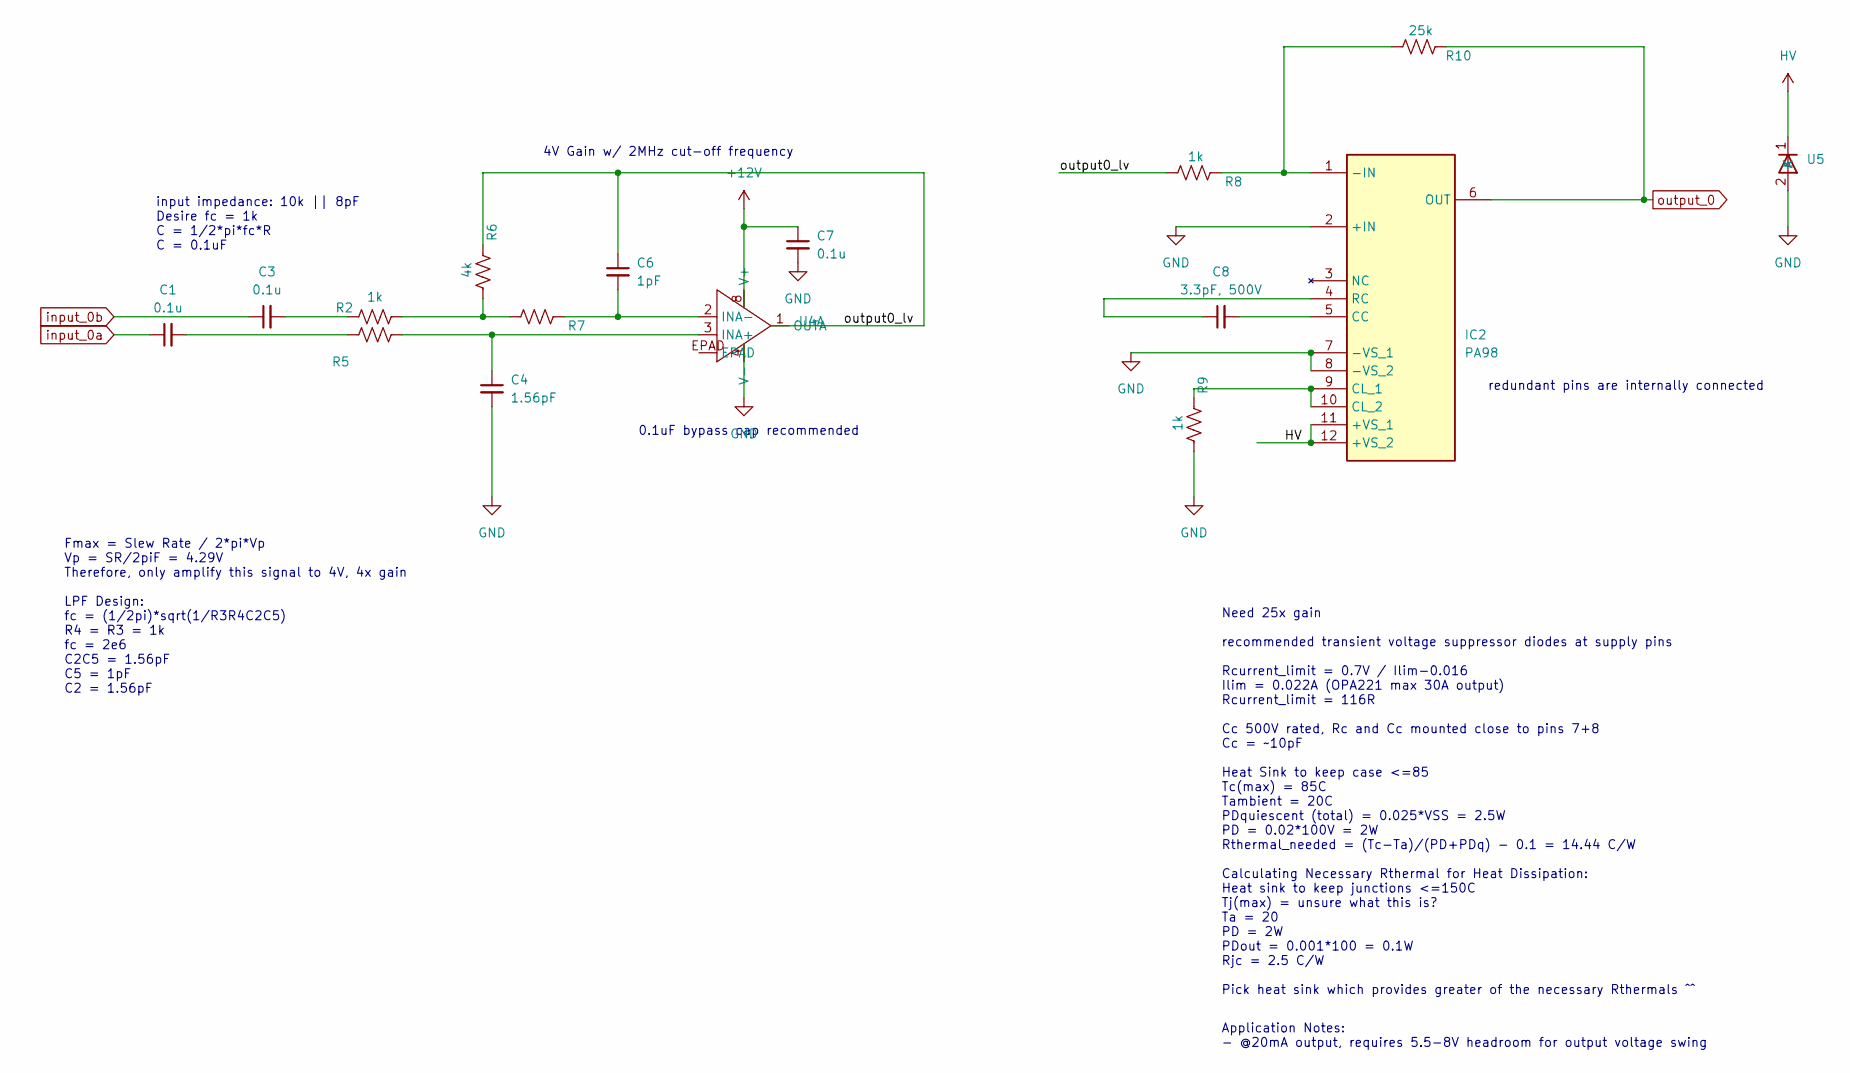
[picture p10: schematic amp0.kicad_sch]

Parts:
C1, C3, C7: 0.1u; C_0603_1608Metric
C4: 1.56pF; C_0603_1608Metric
C6: 1pF; C_0603_1608Metric
C8: 3.3pF, 500V; C_0805_2012Metric
IC2: PA98; Mouser Part Number 137-PA98
R2, R8, R9: 1k; R_0603_1608Metric
R5, R7: R_US; R_0603_1608Metric
R6: 4k; R_0603_1608Metric
R10: 25k; R_0603_1608Metric
U4: OPA2211AIDDAR_L
U5: SMCJ150A-13-F

Connections:
+12V: C7.1, U4.8 (V+); also elsewhere on the board
/amp_0/output0_lv: C6.1, R6.1, R8.2, U4.1 (OUTA)
GND: C4.2, C7.2, IC2.2 (+IN), IC2.7 (-VS_1), IC2.8 (-VS_2), R9.2, U4.4 (V-), U5.2 (A); also elsewhere on the board
HV: IC2.11 (+VS_1), IC2.12 (+VS_2), U5.1 (K); also elsewhere on the board
unnamed: C1.2, R5.2
unnamed: C3.2, R2.2
unnamed: IC2.1 (-IN), R8.1, R10.2
unnamed: C8.2, IC2.5 (CC)
unnamed: IC2.9 (CL_1), IC2.10 (CL_2), R9.1
unnamed: C8.1, IC2.4 (RC)
unnamed: R2.1, R6.2, R7.2
unnamed: C4.1, R5.1, U4.3 (INA+)
unnamed: C6.2, R7.1, U4.2 (INA-)
input_0a: C1.1; also elsewhere on the board
input_0b: C3.1; also elsewhere on the board
output_0: IC2.6 (OUT), R10.1; also elsewhere on the board

Notes on the sheet:
input impedance: 10k || 8pF Desire fc = 1k C = 1/2*pi*fc*R C = 0.1uF
redundant pins are internally connected
4V Gain w/ 2MHz cut-off frequency
Fmax = Slew Rate / 2*pi*Vp Vp = SR/2piF = 4.29V Therefore, only amplify this signal to 4V, 4x gain LPF Design: fc = (1/2pi)*sqrt(1/R3R4C2C5) R4 = R3 = 1k fc = 2e6 C2C5 = 1.56pF C5 = 1pF C2 = 1.56pF
0.1uF bypass cap recommended
Need 25x gain recommended transient voltage suppressor diodes at supply pins Rcurrent_limit = 0.7V / Ilim-0.016 Ilim = 0.022A (OPA221 max 30A output) Rcurrent_limit = 116R Cc 500V rated, Rc and Cc mounted close to pins 7+8 Cc = ~10pF Heat Sink to keep case <=85 Tc(max) = 85C Tambient = 20C PDquiesc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
Application Notes: - @20mA output, requires 5.5-8V headroom for output voltage swing

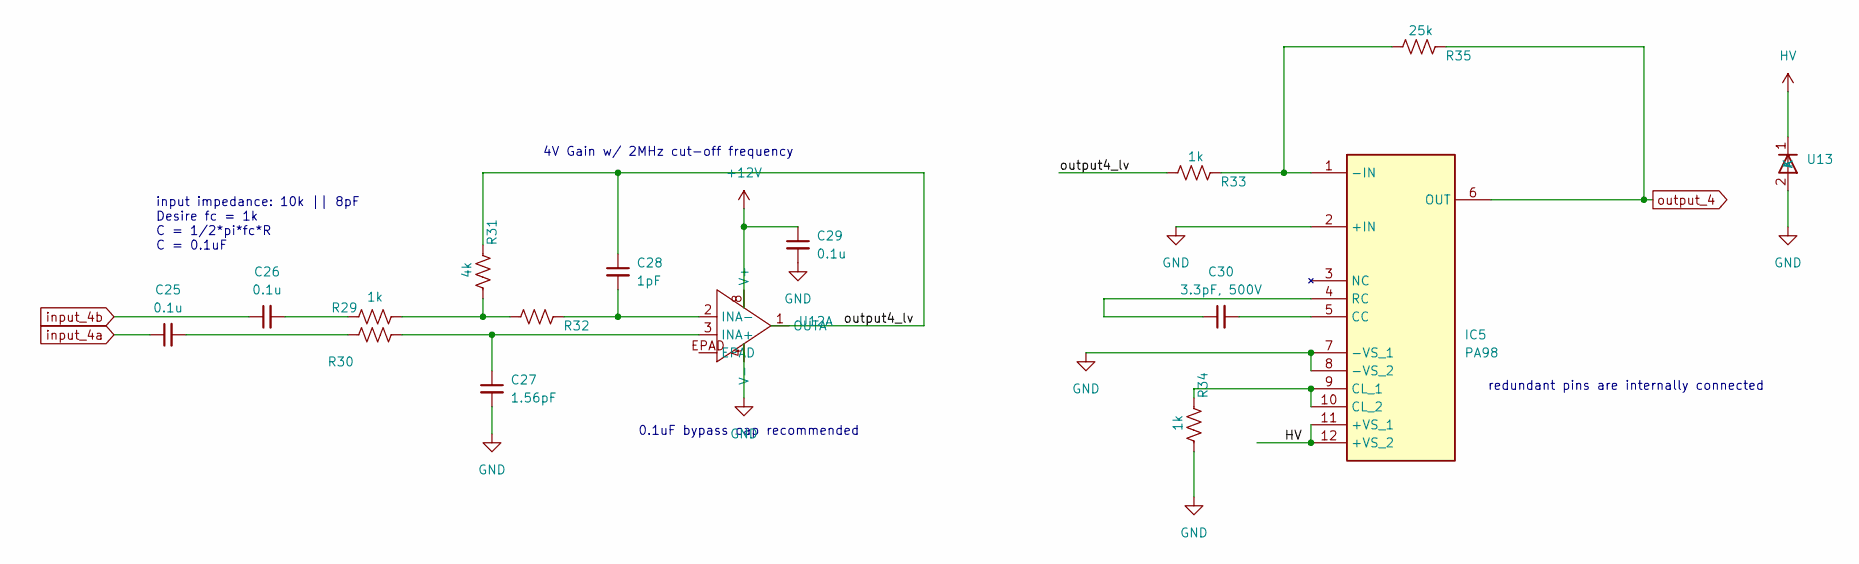
[picture p11: schematic amp_4.kicad_sch]

Parts:
C25, C26, C29: 0.1u; C_0603_1608Metric
C27: 1.56pF; C_0603_1608Metric
C28: 1pF; C_0603_1608Metric
C30: 3.3pF, 500V; C_0805_2012Metric
IC5: PA98; Mouser Part Number 137-PA98
R29, R33, R34: 1k; R_0603_1608Metric
R30, R32: R_US; R_0603_1608Metric
R31: 4k; R_0603_1608Metric
R35: 25k; R_0603_1608Metric
U12: OPA2211AIDDAR_L
U13: SMCJ150A-13-F

Connections:
+12V: C29.1, U12.8 (V+); also elsewhere on the board
/amp_4/output4_lv: C28.1, R31.1, R33.2, U12.1 (OUTA)
GND: C27.2, C29.2, IC5.2 (+IN), IC5.7 (-VS_1), IC5.8 (-VS_2), R34.2, U12.4 (V-), U13.2 (A); also elsewhere on the board
HV: IC5.11 (+VS_1), IC5.12 (+VS_2), U13.1 (K); also elsewhere on the board
unnamed: C25.2, R30.2
unnamed: C26.2, R29.2
unnamed: IC5.1 (-IN), R33.1, R35.2
unnamed: C30.2, IC5.5 (CC)
unnamed: IC5.9 (CL_1), IC5.10 (CL_2), R34.1
unnamed: C30.1, IC5.4 (RC)
unnamed: R29.1, R31.2, R32.2
unnamed: C27.1, R30.1, U12.3 (INA+)
unnamed: C28.2, R32.1, U12.2 (INA-)
input_4a: C25.1; also elsewhere on the board
input_4b: C26.1; also elsewhere on the board
output_4: IC5.6 (OUT), R35.1; also elsewhere on the board

Notes on the sheet:
redundant pins are internally connected
0.1uF bypass cap recommended
4V Gain w/ 2MHz cut-off frequency
input impedance: 10k || 8pF Desire fc = 1k C = 1/2*pi*fc*R C = 0.1uF

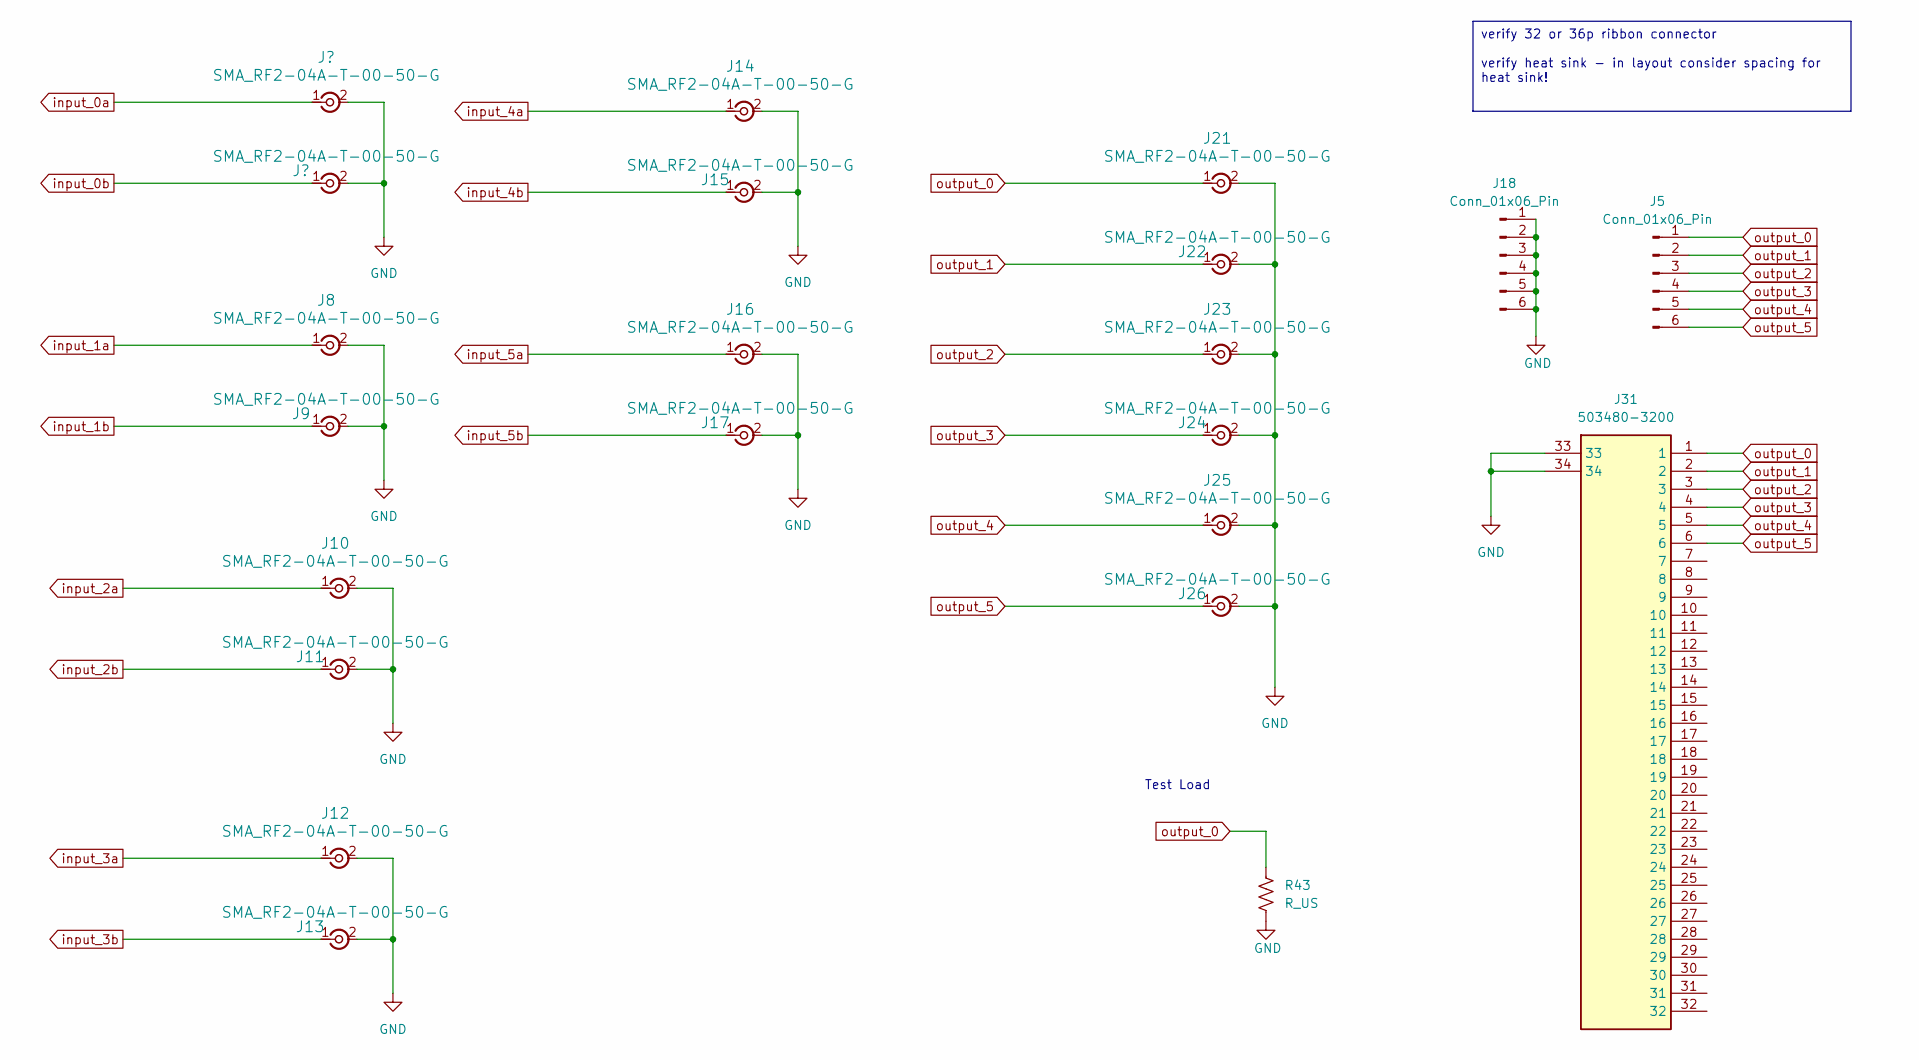
[picture p12: schematic aio.kicad_sch]

Parts:
J5, J18: Conn_01x06_Pin; PinHeader_1x06_P1.00mm_Vertical
J8, J9, J10, J11, J12, J13, J14, J15, J16, J17, J21, J22, J23, J24, J25, J26: SMA_RF2-04A-T-00-50-G; CONN_RF2-04A-T-00-50-G_ADM
J31: 503480-3200; Molex_5034803200; Mouser Part Number 538-503480-3200
R43: R_US; RS02B5K000FB12

Connections:
GND: J8.2, J8.3 (Ext), J8.4 (Ext), J8.5 (Ext), J9.2, J9.3 (Ext), J9.4 (Ext), J9.5 (Ext), J10.2, J10.3 (Ext), J10.4 (Ext), J10.5 (Ext), J11.2, J11.3 (Ext), J11.4 (Ext), J11.5 (Ext), J12.2, J12.3 (Ext), J12.4 (Ext), J12.5 (Ext), J13.2, J13.3 (Ext), J13.4 (Ext), J13.5 (Ext), J14.2, J14.3 (Ext), J14.4 (Ext), J14.5 (Ext), J15.2, J15.3 (Ext), J15.4 (Ext), J15.5 (Ext), J16.2, J16.3 (Ext), J16.4 (Ext), J16.5 (Ext), J17.2, J17.3 (Ext), J17.4 (Ext), J17.5 (Ext), J18.1, J18.2, J18.3, J18.4, J18.5, J18.6, J21.2, J21.3 (Ext), J21.4 (Ext), J21.5 (Ext), J22.2, J22.3 (Ext), J22.4 (Ext), J22.5 (Ext), J23.2, J23.3 (Ext), J23.4 (Ext), J23.5 (Ext), J24.2, J24.3 (Ext), J24.4 (Ext), J24.5 (Ext), J25.2, J25.3 (Ext), J25.4 (Ext), J25.5 (Ext), J26.2, J26.3 (Ext), J26.4 (Ext), J26.5 (Ext), J31.33, J31.34, R43.2; also elsewhere on the board
input_1a: J8.1; also elsewhere on the board
input_1b: J9.1; also elsewhere on the board
input_2a: J10.1; also elsewhere on the board
input_2b: J11.1; also elsewhere on the board
input_3a: J12.1; also elsewhere on the board
input_3b: J13.1; also elsewhere on the board
input_4a: J14.1; also elsewhere on the board
input_4b: J15.1; also elsewhere on the board
input_5a: J16.1; also elsewhere on the board
input_5b: J17.1; also elsewhere on the board
output_0: J5.1, J21.1, J31.1, R43.1; also elsewhere on the board
output_1: J5.2, J22.1, J31.2; also elsewhere on the board
output_2: J5.3, J23.1, J31.3; also elsewhere on the board
output_3: J5.4, J24.1, J31.4; also elsewhere on the board
output_4: J5.5, J25.1, J31.5; also elsewhere on the board
output_5: J5.6, J26.1, J31.6; also elsewhere on the board

Notes on the sheet:
verify 32 or 36p ribbon connector verify heat sink - in layout consider spacing for heat sink!
Test Load

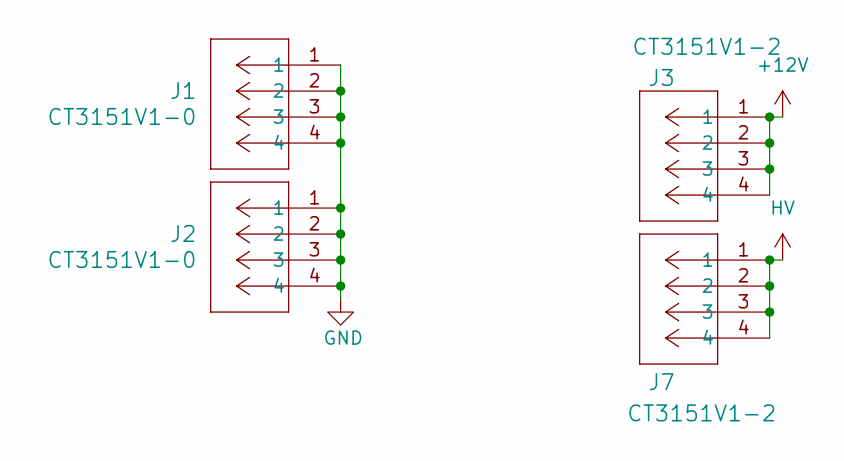
[picture p13: schematic boardPower.kicad_sch]

Parts:
J1, J2: CT3151V1-0; banana_plug_CT3151V1-0
J3, J7: CT3151V1-2; banana_plug_CT3151V1-0

Connections:
+12V: J3.1, J3.2, J3.3, J3.4; also elsewhere on the board
GND: J1.1, J1.2, J1.3, J1.4, J2.1, J2.2, J2.3, J2.4; also elsewhere on the board
HV: J7.1, J7.2, J7.3, J7.4; also elsewhere on the board

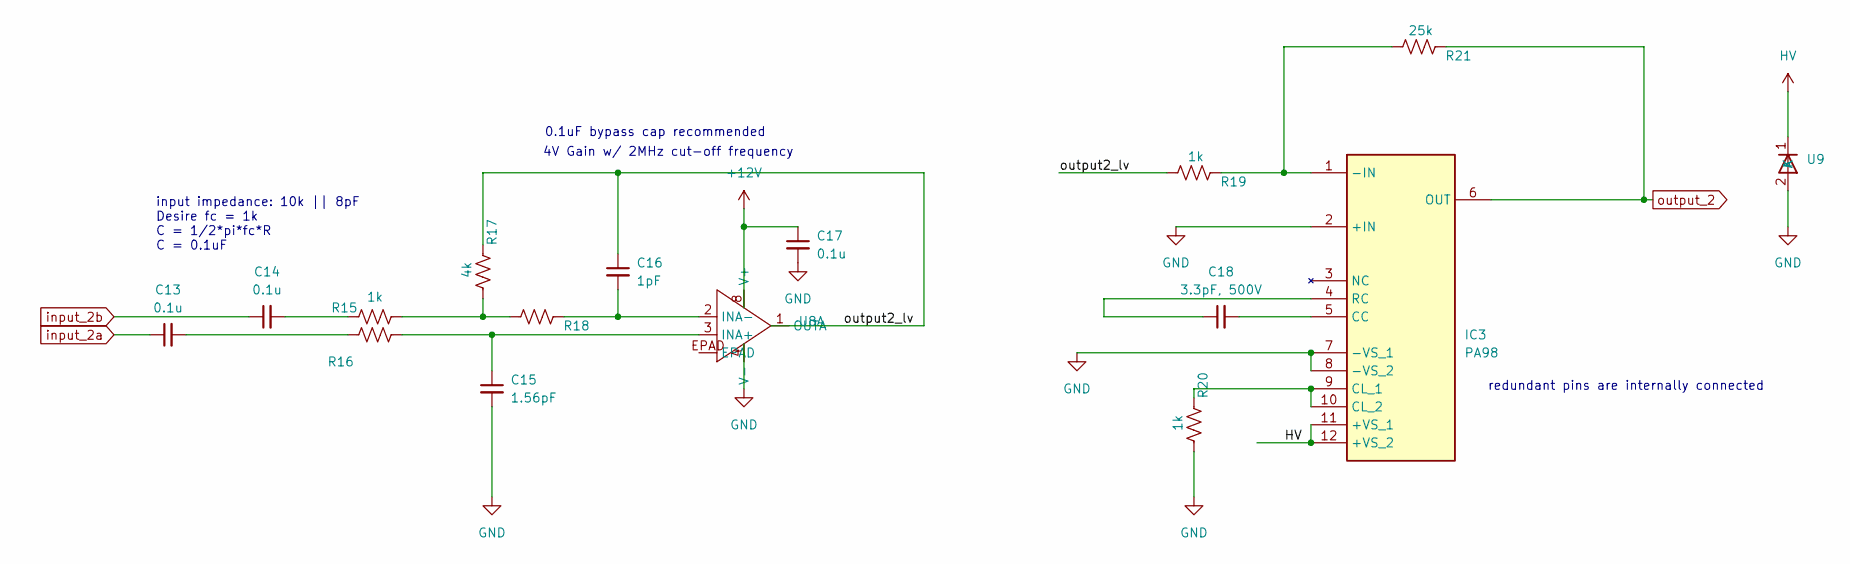
[picture p14: schematic amp_2.kicad_sch]

Parts:
C13, C14, C17: 0.1u; C_0603_1608Metric
C15: 1.56pF; C_0603_1608Metric
C16: 1pF; C_0603_1608Metric
C18: 3.3pF, 500V; C_0805_2012Metric
IC3: PA98; Mouser Part Number 137-PA98
R15, R19, R20: 1k; R_0603_1608Metric
R16, R18: R_US; R_0603_1608Metric
R17: 4k; R_0603_1608Metric
R21: 25k; R_0603_1608Metric
U8: OPA2211AIDDAR_L
U9: SMCJ150A-13-F

Connections:
+12V: C17.1, U8.8 (V+); also elsewhere on the board
/amp_2/output2_lv: C16.1, R17.1, R19.2, U8.1 (OUTA)
GND: C15.2, C17.2, IC3.2 (+IN), IC3.7 (-VS_1), IC3.8 (-VS_2), R20.2, U8.4 (V-), U9.2 (A); also elsewhere on the board
HV: IC3.11 (+VS_1), IC3.12 (+VS_2), U9.1 (K); also elsewhere on the board
unnamed: C13.2, R16.2
unnamed: C14.2, R15.2
unnamed: IC3.1 (-IN), R19.1, R21.2
unnamed: C18.2, IC3.5 (CC)
unnamed: IC3.9 (CL_1), IC3.10 (CL_2), R20.1
unnamed: C18.1, IC3.4 (RC)
unnamed: R15.1, R17.2, R18.2
unnamed: C15.1, R16.1, U8.3 (INA+)
unnamed: C16.2, R18.1, U8.2 (INA-)
input_2a: C13.1; also elsewhere on the board
input_2b: C14.1; also elsewhere on the board
output_2: IC3.6 (OUT), R21.1; also elsewhere on the board

Notes on the sheet:
4V Gain w/ 2MHz cut-off frequency
0.1uF bypass cap recommended
redundant pins are internally connected
input impedance: 10k || 8pF Desire fc = 1k C = 1/2*pi*fc*R C = 0.1uF

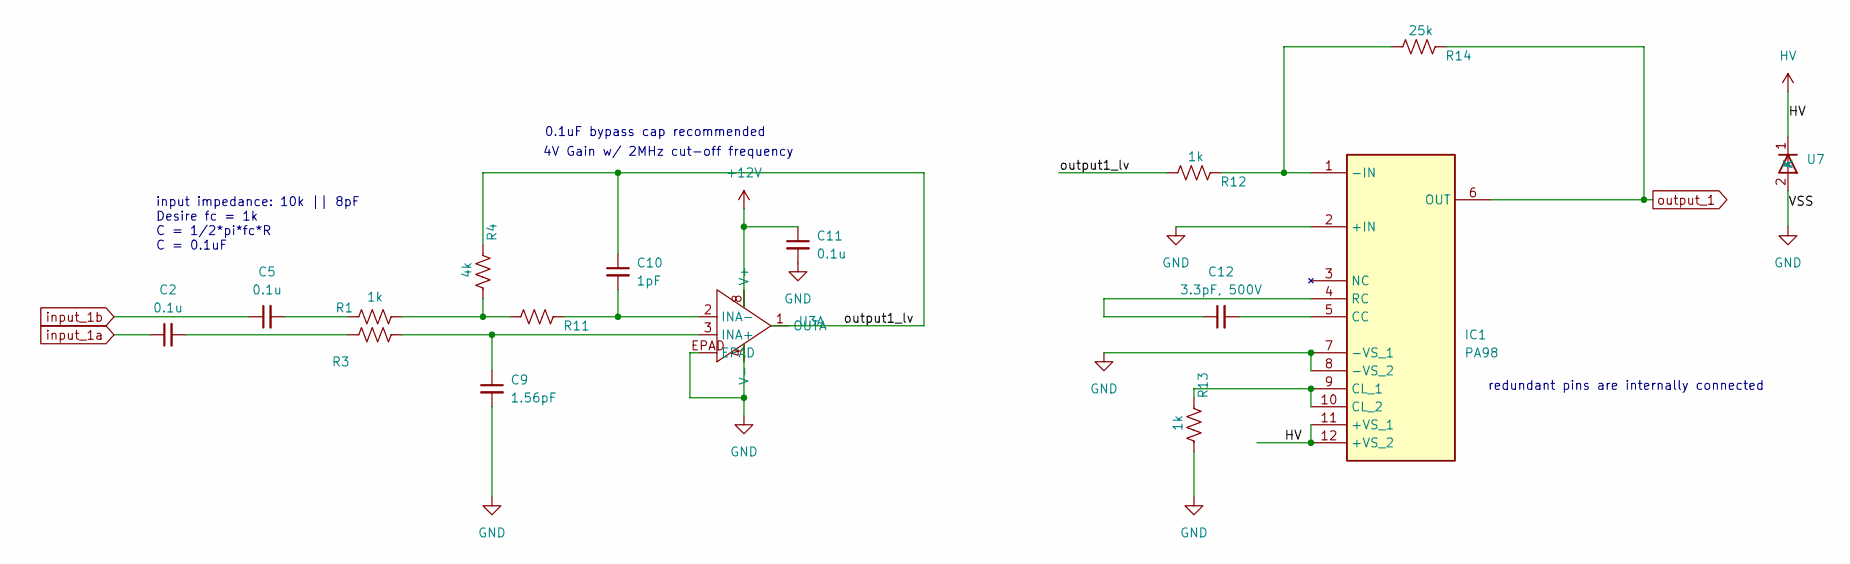
[picture p15: schematic amp_1.kicad_sch]

Parts:
C2, C5, C11: 0.1u; C_0603_1608Metric
C9: 1.56pF; C_0603_1608Metric
C10: 1pF; C_0603_1608Metric
C12: 3.3pF, 500V; C_0805_2012Metric
IC1: PA98; Mouser Part Number 137-PA98
R1, R12, R13: 1k; R_0603_1608Metric
R3, R11: R_US; R_0603_1608Metric
R4: 4k; R_0603_1608Metric
R14: 25k; R_0603_1608Metric
U3: OPA2211AIDDAR_L
U7: SMCJ150A-13-F

Connections:
+12V: C11.1, U3.8 (V+); also elsewhere on the board
/amp_1/output1_lv: C10.1, R4.1, R12.2, U3.1 (OUTA)
GND: C9.2, C11.2, IC1.2 (+IN), IC1.7 (-VS_1), IC1.8 (-VS_2), R13.2, U3.4 (V-), U3.EPAD, U7.2 (A); also elsewhere on the board
HV: IC1.11 (+VS_1), IC1.12 (+VS_2), U7.1 (K); also elsewhere on the board
unnamed: C2.2, R3.2
unnamed: C5.2, R1.2
unnamed: IC1.1 (-IN), R12.1, R14.2
unnamed: C12.2, IC1.5 (CC)
unnamed: IC1.9 (CL_1), IC1.10 (CL_2), R13.1
unnamed: C12.1, IC1.4 (RC)
unnamed: R1.1, R4.2, R11.2
unnamed: C9.1, R3.1, U3.3 (INA+)
unnamed: C10.2, R11.1, U3.2 (INA-)
input_1a: C2.1; also elsewhere on the board
input_1b: C5.1; also elsewhere on the board
output_1: IC1.6 (OUT), R14.1; also elsewhere on the board

Notes on the sheet:
input impedance: 10k || 8pF Desire fc = 1k C = 1/2*pi*fc*R C = 0.1uF
redundant pins are internally connected
4V Gain w/ 2MHz cut-off frequency
0.1uF bypass cap recommended

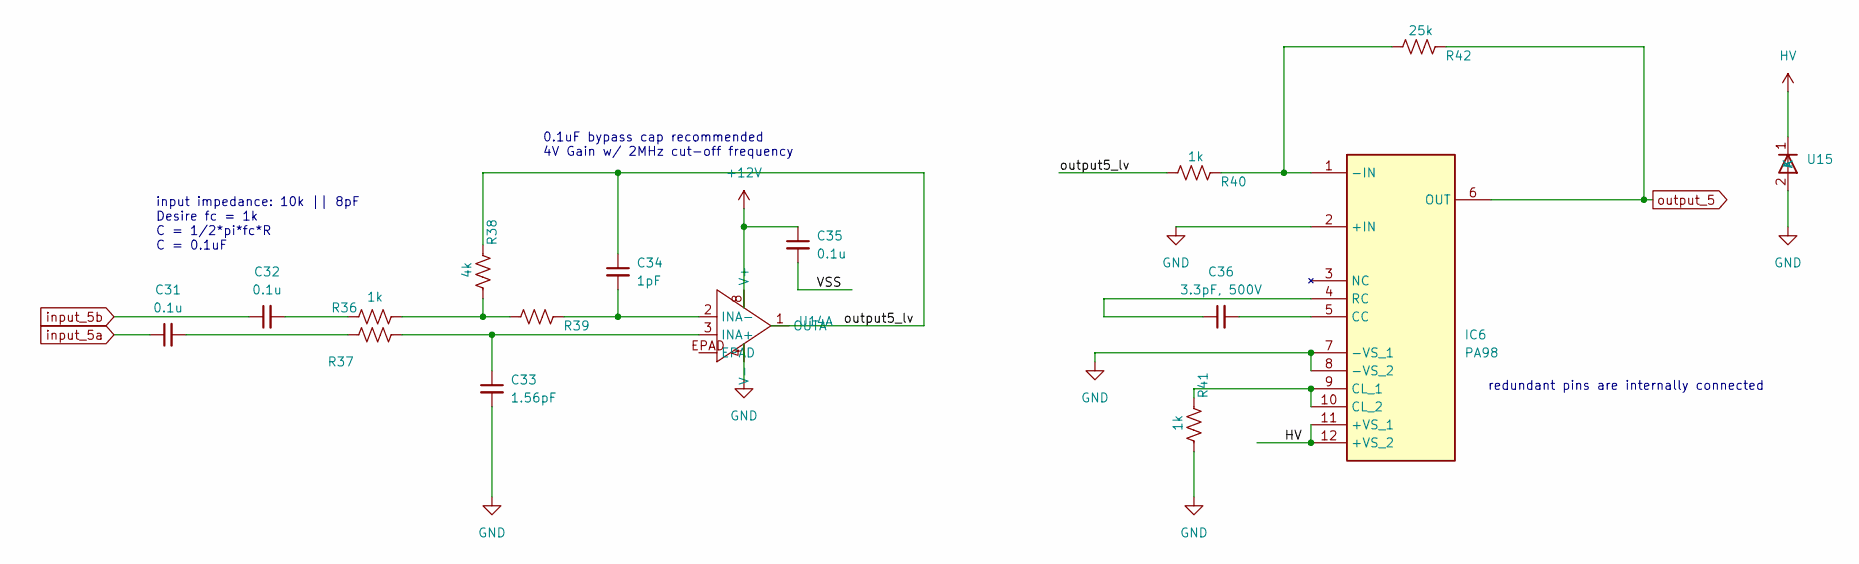
[picture p16: schematic amp_5.kicad_sch]

Parts:
C31, C32, C35: 0.1u; C_0603_1608Metric
C33: 1.56pF; C_0603_1608Metric
C34: 1pF; C_0603_1608Metric
C36: 3.3pF, 500V; C_0805_2012Metric
IC6: PA98; Mouser Part Number 137-PA98
R36, R40, R41: 1k; R_0603_1608Metric
R37, R39: R_US; R_0603_1608Metric
R38: 4k; R_0603_1608Metric
R42: 25k; R_0603_1608Metric
U14: OPA2211AIDDAR_L
U15: SMCJ150A-13-F

Connections:
+12V: C35.1, U14.8 (V+); also elsewhere on the board
/amp_5/VSS: C35.2
/amp_5/output5_lv: C34.1, R38.1, R40.2, U14.1 (OUTA)
GND: C33.2, IC6.2 (+IN), IC6.7 (-VS_1), IC6.8 (-VS_2), R41.2, U14.4 (V-), U15.2 (A); also elsewhere on the board
HV: IC6.11 (+VS_1), IC6.12 (+VS_2), U15.1 (K); also elsewhere on the board
unnamed: C31.2, R37.2
unnamed: C32.2, R36.2
unnamed: IC6.1 (-IN), R40.1, R42.2
unnamed: C36.2, IC6.5 (CC)
unnamed: IC6.9 (CL_1), IC6.10 (CL_2), R41.1
unnamed: C36.1, IC6.4 (RC)
unnamed: R36.1, R38.2, R39.2
unnamed: C33.1, R37.1, U14.3 (INA+)
unnamed: C34.2, R39.1, U14.2 (INA-)
input_5a: C31.1; also elsewhere on the board
input_5b: C32.1; also elsewhere on the board
output_5: IC6.6 (OUT), R42.1; also elsewhere on the board

Notes on the sheet:
redundant pins are internally connected
input impedance: 10k || 8pF Desire fc = 1k C = 1/2*pi*fc*R C = 0.1uF
0.1uF bypass cap recommended
4V Gain w/ 2MHz cut-off frequency

Board: 4 copper layers, 122 parts (0 on the bottom side), 81 nets, no tracks yet.

Other parts of the board:
J4, J6: SMA_RF2-04A-T-00-50-G; CONN_RF2-04A-T-00-50-G_ADM

Their connections:
GND: J4.2, J4.3 (Ext), J4.4 (Ext), J4.5 (Ext), J6.2, J6.3 (Ext), J6.4 (Ext), J6.5 (Ext); also elsewhere on the board
input_0a: J4.1; also elsewhere on the board
input_0b: J6.1; also elsewhere on the board
