mountzelizabeth123/Unphased_schematics/(commit log)

2024-09-24 Icurrent and ADC schem
    [ADC.kicad_sch, Icurrent_sense.kicad_sch]
2024-09-24 ADC swap for multi-channel opamp
    [ADC.kicad_pcb, ADC.kicad_sch, Icurrent_sense.kicad_sch]
2024-09-28 add .gitignore for kicad projects
2024-09-28 reorg repo
    [ADC.kicad_pcb, ADC.kicad_sch, Icurrent_sense.kicad_sch]
2024-09-28 added huxley; removed .DS_Store mac filesystem files from repo; add .DS_Store to .gitignore
    [aio.kicad_sch, chipPower.kicad_sch, dio.kicad_sch, huxley.kicad_pcb, huxley.kicad_sch]
2024-09-28 added analog chip schematics and connector footprints
    [aio.kicad_sch, chipPower.kicad_sch, huxley.kicad_pcb, huxley.kicad_sch, ibias.kicad_sch, isense.kicad_sch]
2024-09-29 updated Ibias gen and footprints
    [aio.kicad_sch, chipPower.kicad_sch, dio.kicad_sch, huxley.kicad_pcb, ibias.kicad_sch, isense.kicad_sch]
2024-09-29 updated footprints
    [aio.kicad_sch, chipPower.kicad_sch, dio.kicad_sch, huxley.kicad_pcb, huxley.kicad_sch, ibias.kicad_sch, isense.kicad_sch]
2024-10-01 added banana plugs and fixed analog discovery pinout
    [aio.kicad_sch, chipPower.kicad_sch, dio.kicad_sch, huxley.kicad_pcb, ibias.kicad_sch]
2024-10-05 reorganized pin assignment to level shifter; matched 3V3 power net name; minor schematic cleanup
    [aio.kicad_sch, chipPower.kicad_sch, dio.kicad_sch, huxley.kicad_pcb, huxley.kicad_sch, ibias.kicad_sch, isense.kicad_sch]
2024-10-05 quick remap of 30pin
    [dio.kicad_sch, huxley.kicad_pcb]
2024-10-08 fixed all bad refs; replaced analog discovery connector; change level shifter 3v3 to from analog discovery
    [aio.kicad_sch, chipPower.kicad_sch, dio.kicad_sch, huxley.kicad_pcb, huxley.kicad_sch, ibias.kicad_sch, isense.kicad_sch]
2024-10-08 move most labels to correct f.silkscreen layer
    [huxley.kicad_pcb]
2024-10-10 minor schematic cleanup; addition of mounting holes; minor layout adjustment
    [aio.kicad_sch, chipPower.kicad_sch, huxley.kicad_pcb, huxley.kicad_sch, ibias.kicad_sch, isense.kicad_sch]
2024-10-13 changed output names to be kicad diffpair-style (+/-); board rearrangement wip
    [aio.kicad_sch, huxley.kicad_pcb, huxley.kicad_sch]
2024-10-18 temp mid-rearrange
    [aio.kicad_sch, huxley.kicad_pcb]
2024-10-20 general rerrange struct inpl
    [huxley.kicad_pcb, ibias.kicad_sch]
2024-10-20 pre edgechange
    [chipPower.kicad_sch, dio.kicad_sch, huxley.kicad_pcb]
2024-10-20 I can't believe it's not butter
    [huxley.kicad_pcb]
2024-10-22 prettier; manufacturing outputs
    [huxley-B_Cu.gbr, huxley-B_Mask.gbr, huxley-B_Paste.gbr, huxley-B_Silkscreen.gbr, huxley-C_Cu.gbr, huxley-Edge_Cuts.gbr, huxley-F_Cu.gbr, huxley-F_Mask.gbr]
2024-10-22 added DNP prop to some caps and updated bom; added regular and rounded board outputs
    [aio.kicad_sch, chipPower.kicad_sch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]
2024-10-22 added .csv files (boms, footprint pos .csvs)
    [huxley_bom.csv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]
2024-10-23 amp board
    [aio.kicad_sch, amp0.kicad_sch, amp_1.kicad_sch, amp_2.kicad_sch, amp_3.kicad_sch, amp_4.kicad_sch, amp_5.kicad_sch, amp_board.kicad_pcb]
2024-10-23 huxley bom updated
    [huxley_bom.csv]
2024-10-23 add sierra format bom for huxley v1
    [huxley_v1_sierra_bom.xls]
2024-11-08 removed all via-in-pad; added CLK connection to analogdiscovery signal generator
    [dio.kicad_sch, huxley.kicad_pcb, huxley.kicad_sch]
2024-11-08 updated huxley-rounded to v1.1
    [huxley-rounded.kicad_pcb, huxley.kicad_pcb]
2024-11-08 updated outputs for huxley v1.1
    [huxley-rounded-B_Cu.gbr, huxley-rounded-B_Mask.gbr, huxley-rounded-B_Paste.gbr, huxley-rounded-B_Silkscreen.gbr, huxley-rounded-C_Cu.gbr, huxley-rounded-Edge_Cuts.gbr, huxley-rounded-F_Cu.gbr, huxley-rounded-F_Mask.gbr]
2024-11-19 DFA fixes; bump huxley version number to v1.1.1; added updated BOM v1.1.1
    [aio.kicad_sch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]
